kokospalme/HW_LipoMeter5S/Docs/ESP_LayoutPins.fld/image001.jpg

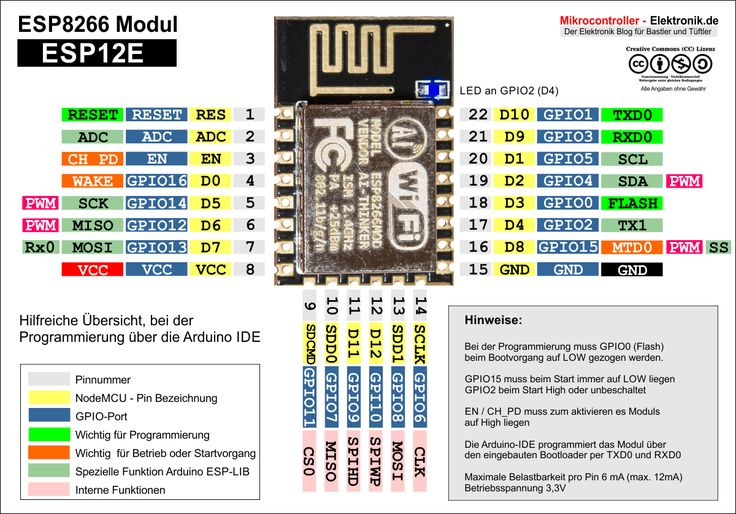
Docs/ESP_LayoutPins.fld/image001.jpg
