kokospalme/HW_LipoMeter5S/Docs/ESP_LayoutPins.fld/image003.png

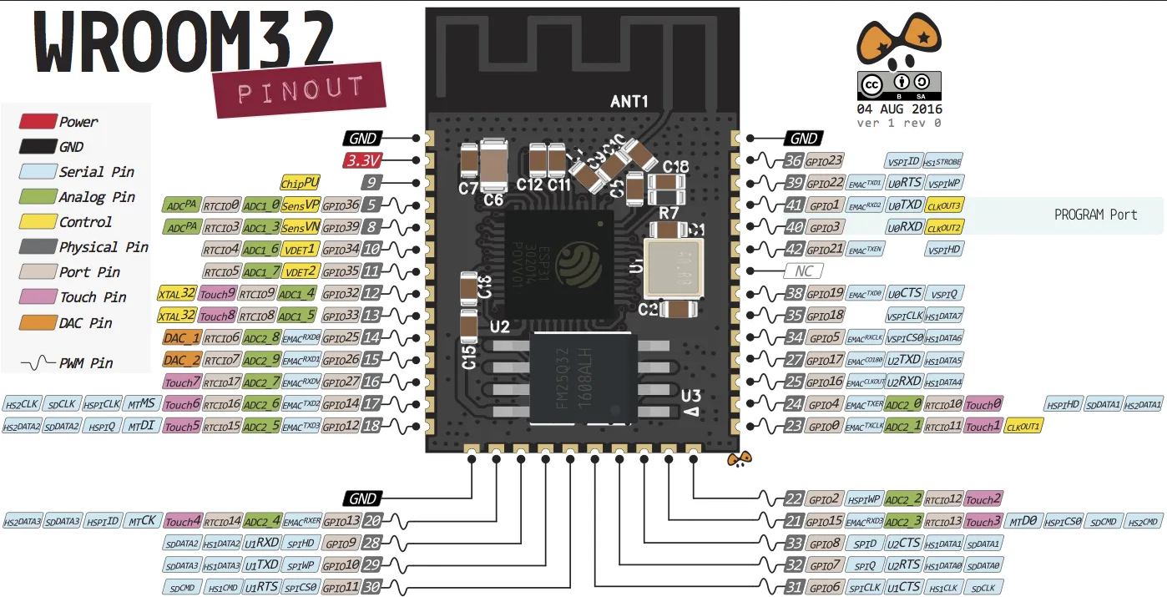
Docs/ESP_LayoutPins.fld/image003.png
