kokospalme/HW_LipoMeter5S/Docs/ESP_LayoutPins.docx

# ESP8266

## Layout


## Pins

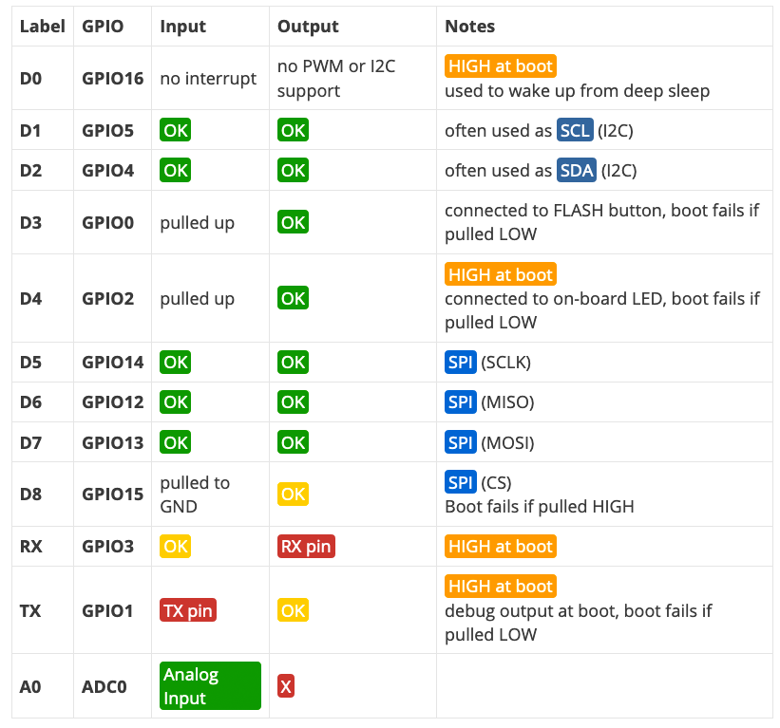
[picture p3: figure]

# ESP32

## Layout (32D)


## Pins

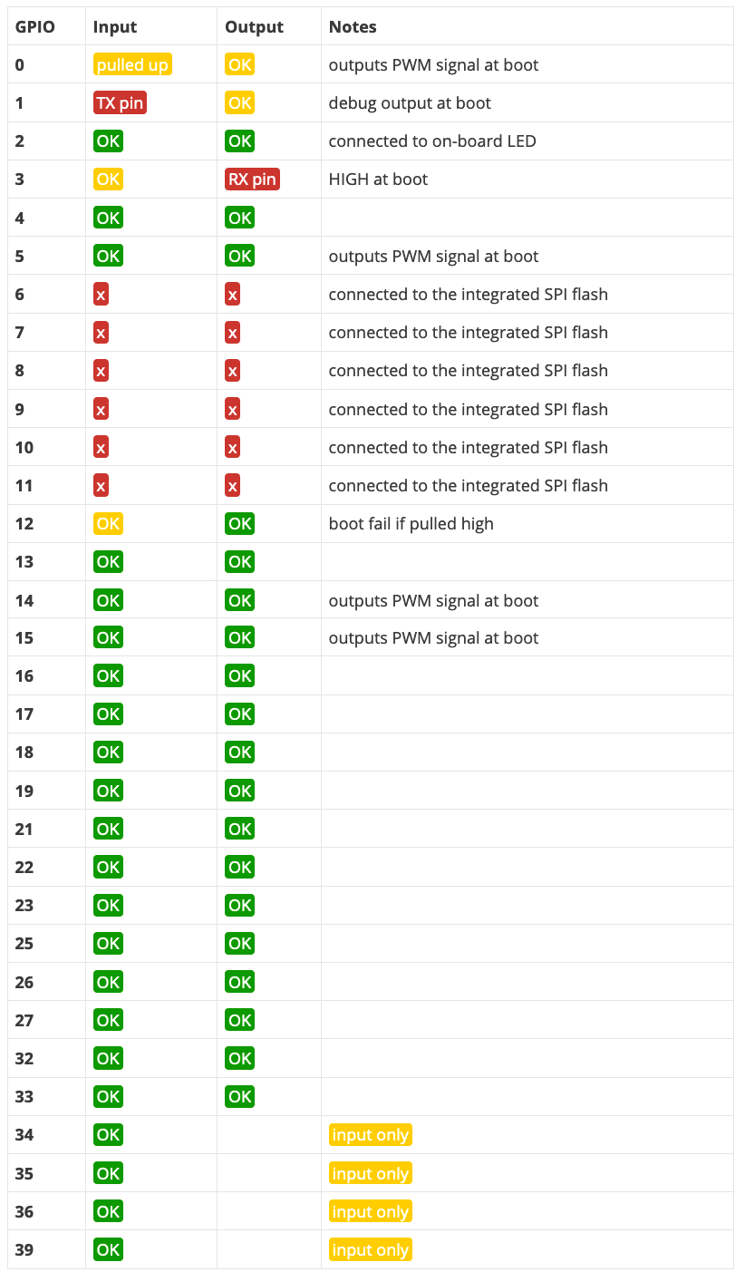
[picture p4: figure]

# ESP-WROOM-02

## Layout

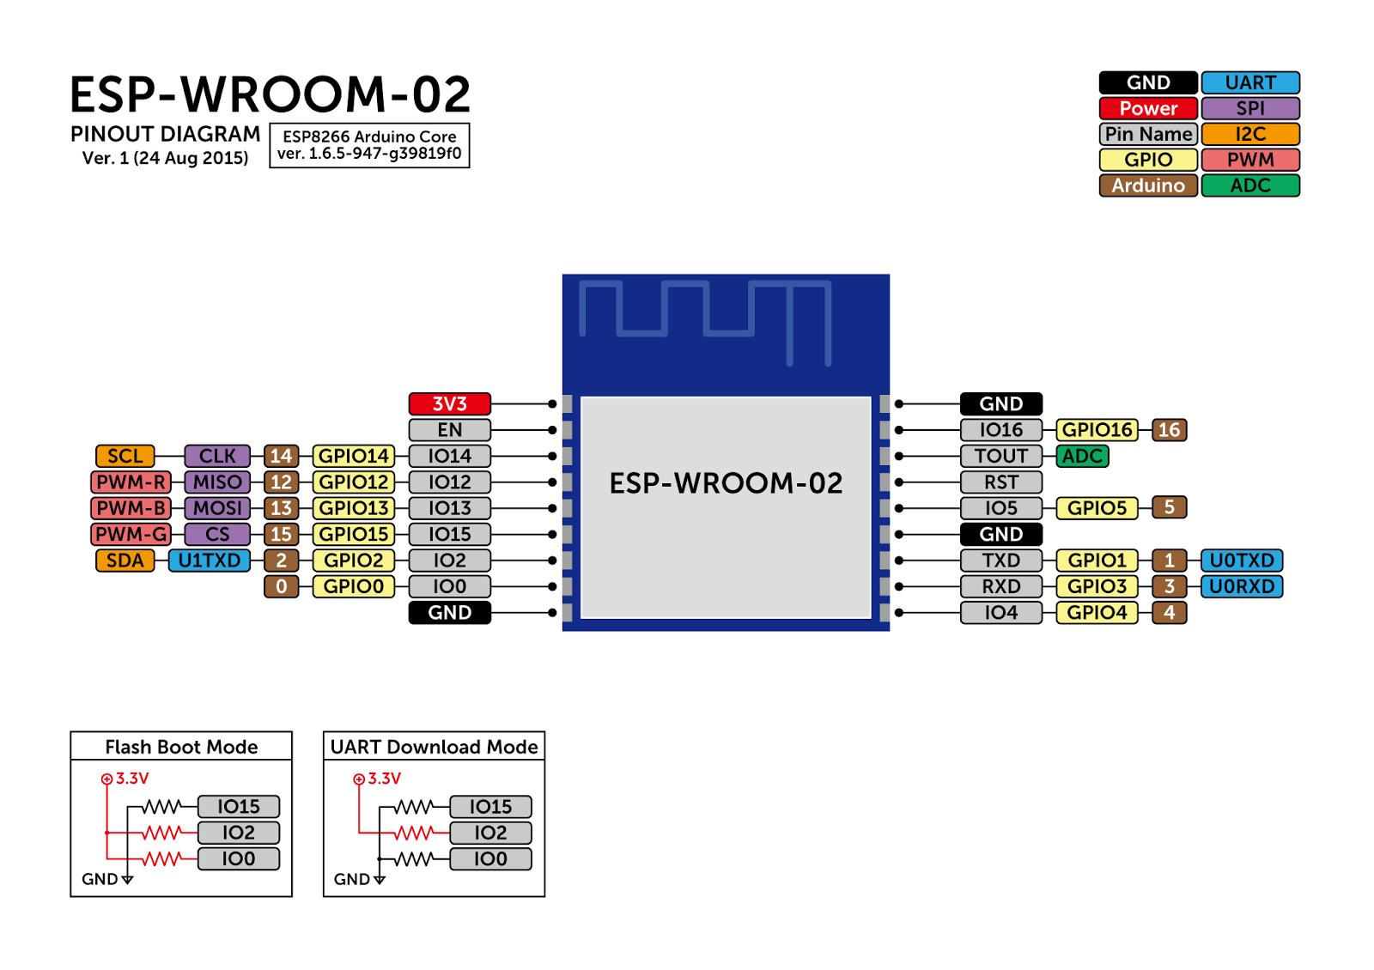
[picture p5: figure]
