kokospalme/HW_LipoMeter5S/Docs/Alice' Hase2.bmp

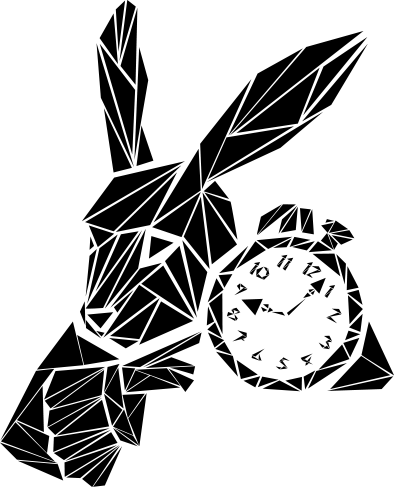
Docs/Alice' Hase2.bmp
