kokospalme/HW_LipoMeter5S/PicoPar6/CAD/par-16-1.snapshot.2/Par-16-Ring-3.png

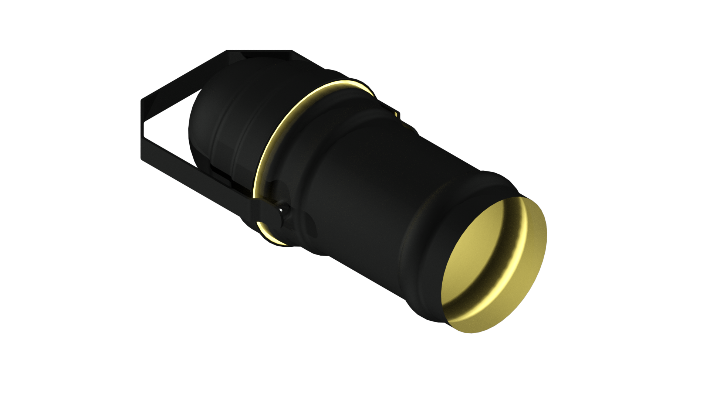
PicoPar6/CAD/par-16-1.snapshot.2/Par-16-Ring-3.png
