kokospalme/HW_LipoMeter5S/PicoPar6/PicoPar6_LED3x/CAD/Zusammenbau_2020-Apr-13_08-45-55PM-000_CustomizedView1124042807_png.png

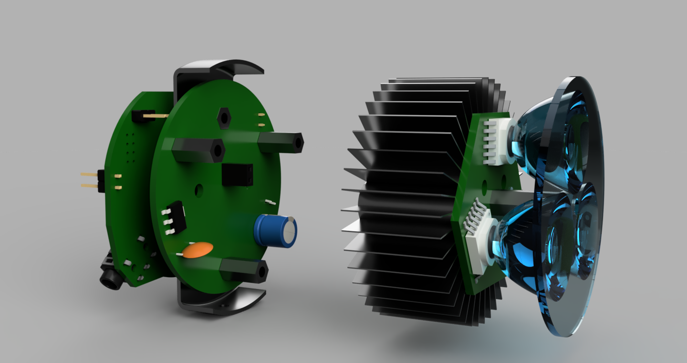
PicoPar6/PicoPar6_LED3x/CAD/Zusammenbau_2020-Apr-13_08-45-55PM-000_CustomizedView1124042807_png.png
