kokospalme/HW_LipoMeter5S/PicoPar6/PicoPar6_LED3x/CAD/Zusammenbau_2020-Apr-13_08-47-48PM-000_CustomizedView13101867357_png.png

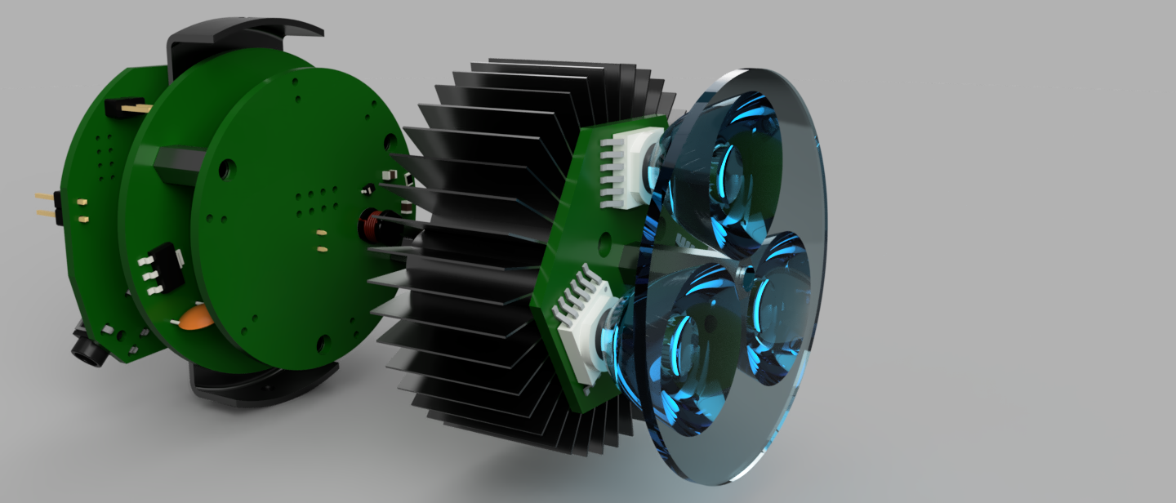
PicoPar6/PicoPar6_LED3x/CAD/Zusammenbau_2020-Apr-13_08-47-48PM-000_CustomizedView13101867357_png.png
