kokospalme/HW_LipoMeter5S/ArtnetNode/ArtnetNodeV0_5BOM.xlsx

Comment | Designator | Footprint | LCSC
100nF | C1,C8,C9,C7,C10,C11,C12 | Capacitor SMD:C 0805 2012 Metric
100uF | C2 | C109392
100nF | C3,C4,C6,C5 | Capacitor SMD 0603 Metric
LED_PWR | D1 | C228
WS2812B | D2,D3 | LED_SMD:LED_WS2812B_PLCC4_5.0x5.0mm_P3.2mm
USB_B_Micro | J1 | C482361
NEOP2D | J10 | C131337
ANALOG | J11 | Connector_PinSocket_2.54mm:PinSocket_2x04_P2.54mm_Vertical
DIO | J12 | Connector_PinSocket_2.54mm:PinSocket_2x06_P2.54mm_Vertical
Jack-DC | J2 | C381116
CON_PROG | J4 | PinSocket_1x03_P2.54mm_Vertical
DMX2 | J5 | C131339
DMX1 | J6 | C131339
DMXIN | J7 | C131339
NEOP1D | J8 | C131337
NEOP1C | J9 | C131337
PWR_SEL | JP1 | -
1k | R1,R5,R2,R16 | Resistor_SMD 0603 Metric
20k | R22,R24,R28,R26,R39,R37 | Resistor_SMD 0603 Metric
120 | R23,R27,R38 | Resistor_SMD 0603 Metric
4.7k | R3,R4 | Resistor_SMD 0603 Metric
100 | R40,R42,R46 | Resistor_SMD 0603 Metric
10 | R41,R43,R44,R45,R47,R48 | Resistor_SMD 0603 Metric
10k | R6,R8,R7,R9,R11,R13,R12,R10,R15,R18,R35,R34,R33,R36,R14,R17,R19,R20,R21,R25,R29,R30,R31,R32 | Resistor_SMD 0603 Metric
SW_Reset | SW1 | KAN0441C-0252C1 (https://lcsc.com/product-detail/Others_GANGYUAN-KAN0441C-0252C1_C231732.html)
SW_PROG | SW2 | KAN0441C-0252C2 (https://lcsc.com/product-detail/Others_GANGYUAN-KAN0441C-0252C1_C231732.html)
SW_NEX | SW3 | KAN0441C-0252C3
SW_NL | SW4 | KAN0441C-0252C4
SW_NR | SW5 | KAN0441C-0252C5
SW_NENT | SW6 | KAN0441C-0252C6
LM1117-5.0 | U1 | C126028
W5500_mini | U12 | custom:W5500_mini
LM1117-3.3 | U2 | SOT-223-3
ESP32-WROOM | U3 | ESP32-WROOM-32U (https://lcsc.com/product-detail/_Espressif-Systems-ESP32-WROOM-32U_C328062.html)
OLED_0.96-I2C | U4 | KiCad-SSD1306_OLED-0:SSD1306_OLED-0.96-128x64_I2C
PCA9555 | U5 | SSOP-24_5.3x8.2mm_P0.65mm
MAX485E | U7,U10,U6 | SOIC-8_3.9x4.9mm_P1.27mm
SN65176D | U8,U9,U11 | SOIC-8_3.9x4.9mm_P1.27mm
