kokospalme/HW_LipoMeter5S/PicoPar6/BOM/LCSC_Exported_20200412_154108.xlsx

LCSC Part Number | Manufacture Part Number | Manufacturer | Package | Customer # | C357398 | Order Qty. | Unit Price | PCB | PCB Qty | PCB2 | PCB Qty2 | units p PCB | price pPCB
C347101 | RS-05MR200FT | FH(Guangdong Fenghua Advanced Tech) | 0805 |  | 0.2 ±1% 1/8W 0805 Chip Resistor - Surface Mount RoHS | 50 | 0.006560 € | - |  |  |  | 0 | 0
C111516 | SPHD-002T-P0.5 | JST Sales America | - |  | Crimping terminal 24~28 0.08~0.21 UL , RoHS , CSA Terminals RoHS | 100 | 0.010421 € | DRV | 12 |  |  | 12 | 0.125052
C113628 | AL8807W5-7 | Diodes Incorporated | SOT-25 |  | DC DC Regulator Step-down 有 6V 36V SOT-25 LED Drivers RoHS | 30 | 0.305455 € | DRV | 6 |  |  | 6 | 1.83273
C131337 | B2B-PH-K-S(LF)(SN) | JST Sales America | Through Hole |  | PH Header Male Pin 0.079"(2.00mm) 2 Through Hole Wire To Board / Wire To Wire Connector RoHS | 40 | 0.028961 € | DRV | 6 |  |  | 6 | 0.173766
C155590 | BAT20JFILM | STMicroelectronics | SOD-323 |  | 23V 1A 620mV @ 1A SOD-323 Schottky Barrier Diodes (SBD) RoHS | 30 | 0.066167 € | DRV | 6 |  |  | 6 | 0.397002
C157955 | PHR-2 | JST Sales America | P=2mm |  | PH 2 0.079"(2.00mm) 1 Male P=2mm Rectangular Connectors Housings RoHS | 50 | 0.011696 € | DRV | 6 | MAINSUP | 1 | 7 | 0.081872
C157975 | B8B-PHDSS(LF)(SN) | JST Sales America | Through Hole,P=2mm |  | PHD Header Male Pin 0.079"(2.00mm) 8 Through Hole,P=2mm Wire To Board / Wire To Wire Connector RoHS | 5 | 0.260909 € | DRV | 1 | MAIN | 1 | 2 | 0.521818
C253597 | ABG06A45M330 | COILANK INTERNATIONAL | SMD,6x6mm |  | 33uH ±20% 1.49A 132mΩ SMD,6x6mm Power Inductors RoHS | 30 | 0.078257 € | DRV | 6 |  |  | 6 | 0.469542
C28323 | CL21B105KBFNNNE | Samsung Electro-Mechanics | 0805 |  | 1uF ±10% 50V X7R 0805 Multilayer Ceramic Capacitors MLCC - SMD/SMT RoHS | 60 | 0.018812 € | DRV | 6 | MAIN | 2 | 8 | 0.150496
C304874 | RS-05MR22JT | FH(Guangdong Fenghua Advanced Tech) | 0805 |  | 0.22 ±5% 1/8W 0805 Chip Resistor - Surface Mount RoHS | 50 | 0.009769 € | DRV | 6 |  |  | 6 | 0.058614
C343626 | 1520-1140CNG0S087001 | HOAUC | Through Hole,P=2mm |  | Pin Header Male Pin 0.079"(2.00mm) 40 1 Through Hole,P=2mm Pin Header & Female Header RoHS | 5 | 0.089702 € | DRV | 0.05 |  |  | 0.05 | 0.0044851
C49217 | 0805F225M500NT | FH(Guangdong Fenghua Advanced Tech) | 0805 |  | 2.2uF ±20% 50V Y5V 0805 Multilayer Ceramic Capacitors MLCC - SMD/SMT RoHS | 40 | 0.029801 € | DRV | 6 |  |  | 6 | 0.178806
C103955 | RTT05121JTP | RALEC | 0805 |  | 120 ±5% 1/8W ±100ppm/°C 0805 Chip Resistor - Surface Mount RoHS | 100 | 0.002262 € | MAIN | 1 |  |  | 1 | 0.002262
C126027 | LM1117S-3.3 | HTC Korea TAEJIN Tech | SOT-223 |  | Fixed 12V 3.3V 1A SOT-223 Low Dropout Regulators(LDO) RoHS | 5 | 0.119779 € | MAIN | 1 |  |  | 1 | 0.119779
C169103 | CRCW060310K0JNEA | Vishay Intertech | 0603 |  | 10K ±5% 1/10W 0603 Chip Resistor - Surface Mount RoHS | 100 | 0.006405 € | MAIN | 11 |  |  | 11 | 0.070455
C18167 | C18167 | BOOMELE(Boom Precision Elec) | Through Hole |  | 3.5mm Plug-in headphone holder 5 Female Horizontal Through Hole Audio & Video Connectors RoHS | 20 | 0.054684 € | MAIN | 2 |  |  | 2 | 0.109368
C269707 | RMC060320K1%N | TyoHM | 0603 |  | 20K ±1% 1/10W 0603 Chip Resistor - Surface Mount RoHS | 100 | 0.002541 € | MAIN | 2 |  |  | 2 | 0.005082
C426569 | BSS138 | Slkor(SLKORMICRO Elec.) | SOT-23 |  | N Channel 50V 220mA 1.6V @ 1mA 3.5Ω @ 220mA,10V 225mW SOT-23 MOSFET RoHS | 50 | 0.011741 € | MAIN | 2 |  |  | 2 | 0.023482
C468242 | SN75176ADR | Texas Instruments | SOIC-8 |  | SOIC-8 Logic-Buffers, Drivers, Receivers, Transceivers RoHS | 5 | 0.308636 € | MAIN | 1 |  |  | 1 | 0.308636
C10752 | 1000uF 10V 8*12 | CX(Dongguan Chengxing Elec) | Radial,8x12mm |  | 1000uF ±20% 10V 8x12 2000Hrs @ 105℃ Radial,8x12mm Aluminum Electrolytic Capacitors - Leaded RoHS | 20 | 0.026452 € | MAINSUP | 1 |  |  | 1 | 0.026452
C173752 | S2B-PH-K-S(LF)(SN) | JST Sales America | Through Hole,P=2mm |  | PH Header Male Pin 0.079"(2.00mm) 2 Through Hole,P=2mm Wire To Board / Wire To Wire Connector RoHS | 20 | 0.038959 € | MAINSUP | 1 |  |  | 1 | 0.038959
C353913 | CC1H104ZC4PD3F5P30MF | Dersonic | Through Hole,P=5.08mm |  | 100nF -20%~+80% 50V Through Hole,P=5.08mm Ceramic Disc Capacitors RoHS | 50 | 0.010166 € | MAINSUP | 1 |  |  | 1 | 0.010166
C49661 | C49661 | BOOMELE(Boom Precision Elec) | P=2.54mm |  | Female Header Female Socket 0.100"(2.54mm) 2 1 P=2.54mm Pin Header & Female Header RoHS | 40 | 0.027342 € | MAINSUP | 2 |  |  | 2 | 0.054684
C305416 |  |  | TO-220 |  | LM7805 |  | 0.166136 € | MAINSUP | 1 |  |  | 1 | 0.166136
C114586 | WS2812B-B | Worldsemi | SMD,5x5mm | 1 | RGB 620~630nmRed,515~530nmGreen,465~475nmBlue SMD,5x5mm Light Emitting Diodes (LED) RoHS | 5 | 0.099749 € | UI | 1 |  |  | 1 | 0.099749
C123700 | HP-5M3*5 | HIWA | M3*5 |  | M3*5 Studs RoHS | 40 | 0.020776 € |  |  |  |  | 0 | 0
C139741 | C139741 | Made in China | M3 |  | M3 Screw RoHS | 50 | 0.004642 € |  |  |  |  | 0 | 0
C158133 | RTT05R240FTP | RALEC | 0805 |  | 0.24 ±1% 1/8W ±200ppm/°C 0805 Chip Resistor - Surface Mount RoHS | 50 | 0.003641 € |  |  |  |  | 0 | 0
C185215 | 22041021 | MOLEX | Through Hole |  | Header Male Pin 0.098"(2.50mm) 2 Through Hole Wire To Board / Wire To Wire Connector RoHS | 30 | 0.051912 € |  |  |  |  | 0 | 0
C24084 | 0805W8F300LT5F | UNI-ROYAL(Uniroyal Elec) | 0805 |  | 0.3 ±1% 1/8W ±800ppm/°C 0805 Chip Resistor - Surface Mount RoHS | 50 | 0.004544 € |  |  |  |  | 0 | 0
C277657 | 511910200 | MOLEX | - |  | Connectors - Housings RoHS | 30 | 0.046259 € |  |  |  |  | 0 | 0
C293610 | 508029001 | MOLEX | - |  | Terminals RoHS | 100 | 0.019325 € |  |  |  |  | 0 | 0
C357397 | PM3X4 | Shuntian | 3X4mm |  | 3X4mm Screw RoHS | 100 | 0.002488 € |  |  |  |  | 0 | 0
C357398 | PM3X5 | Shuntian | 3X5mm |  | 3X5mm Screw RoHS | 100 | 0.002597 € |  |  |  |  | 0 | 0
C357546 | PM3X12 | Shuntian | 3X12mm |  | 3X12mm Screw RoHS | 50 | 0.004410 € |  |  |  |  | 0 | 0
C55707 | C55707 | Made in China | 3*10mm |  | 3*10mm Studs RoHS | 20 | 0.023978 € |  |  |  |  | 0 | 0
C87703 | C87703 | Made in China | M3*5+6 |  | M3*5+6 Studs RoHS | 20 | 0.022721 € |  |  |  |  | 0 | 0
 |  |  |  |  |  |  |  |  |  |  |  | Bauteile | 5.0293931
