kokospalme/HW_LipoMeter5S/PicoPar6/BOM/picoPar6_stairvile_screwBOM_V1.0.xlsx

Anzahl pcb | Anzahl gesamt | Name | material | LCSC
2 | 10 | screw M3x15 | stahl
3 | 15 | screw M3x5 | stahl | C357398
1 | 5 | nut M3 | stahl | C133377
2 | 10 | stud M3x5 | nylon | C123700
2 | 10 | stud M3x5 | stahl | C123700
3 | 15 | stud M3x10 | stahl | C55707
