kokospalme/HW_LipoMeter5S/PicoPar6/PicoPar6_Driver/EasyEDA_PicoPar6_DriverPCB_V1_0/Pico6 Par_Driver PCB_V1_0_BOM.csv

ID | Name | Designator | Footprint | Quantity | Manufacturer Part | Manufacturer | Supplier | Supplier Part | LCSC Assembly
1 | AL8805 | U2,U6,U1,U3,U5,U4 | SOT23-5 | 6 | AL8805W5-7 | Diodes Incorporated | LCSC | C127927
2 | 1uF | C3,C1,C5,C11,C9,C7 | 0805' | 6 | CL21B105KBFNNNE | SAMSUNG | LCSC | C28323
3 | 2.2uF | C4,C2,C6,C12,C10,C8 | 0805' | 6 | 0805F225M500NT | FH | LCSC | C49217
4 | 0.3R | R1,R3,R6,R5,R2,R4 | 0805' | 6 | 0805W8F300LT5F | UniOhm | LCSC | C24084
5 | 33uH | L1,L2,L3,L5,L6,L4 | SRN6045 | 6 | SWRB1207S-330MT | Sunlord | LCSC | C169375
6 | BAT20JFILM | D1,D3,D2,D5,D6,D4 | SOD-323_L1.8-W1.3-LS2.5-RD | 6 | BAT20JFILM | STMicroelectronics | LCSC | C155590 | Yes
7 | P_CTRL | P1 | HDR-TH_8P-P2.54-V-R2-C4-S2.54 | 1 | Header2X4P 2.54mm | ReliaPro | LCSC | C58363
8 | CH_W | P6 | CONN-TH_22041021 | 1 | 22041021 | MOLEX | LCSC | C185215
9 | CH_UV | P7 | CONN-TH_22041021 | 1 | 22041021 | MOLEX | LCSC | C185215
10 | P_PWR | P2 | CONN-TH_22041021 | 1 | 22041021 | MOLEX | LCSC | C185215
11 | CH_B | P5 | CONN-TH_22041021 | 1 | 22041021 | MOLEX | LCSC | C185215
12 | CH_G | P4 | CONN-TH_22041021 | 1 | 22041021 | MOLEX | LCSC | C185215
13 | CH_R | P3 | CONN-TH_22041021 | 1 | 22041021 | MOLEX | LCSC | C185215
14 | CH_A | P8 | CONN-TH_22041021 | 1 | 22041021 | MOLEX | LCSC | C185215
