kokospalme/HW_LipoMeter5S/PicoPar6/CAD/MainSupply/PicoPar6_MainSupply_V1_0.step

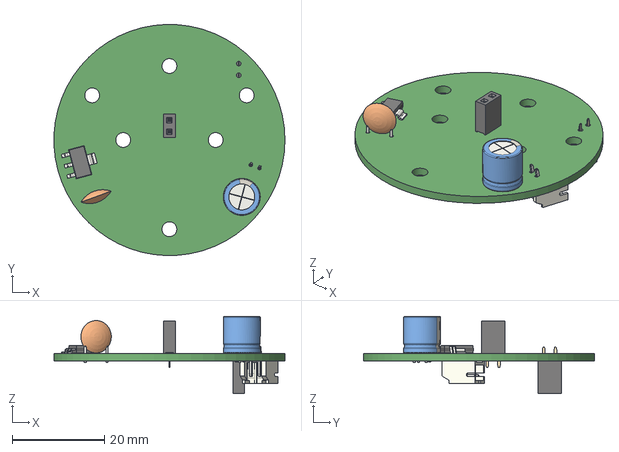
[picture p10: CAD file, 2020-04-25]
PicoPar6/CAD/MainSupply/PicoPar6_MainSupply_V1_0.step
50.0 x 50.0 x 16.7 mm
