kokospalme/HW_LipoMeter5S/PicoPar6/PicoPar6_Mainboard/V2/Gerber/PicoPar6_Mainboard-Edge_Cuts.dxf

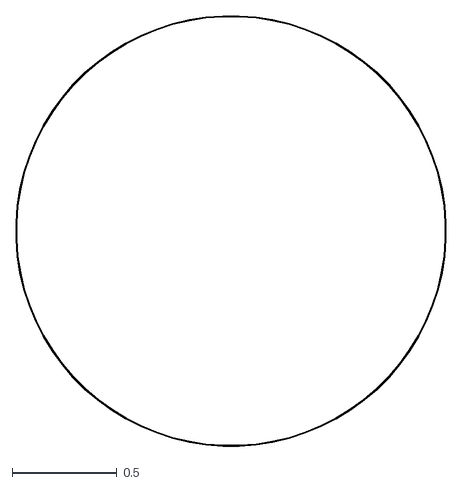
[picture p11: CAD file, 2020-04-25]
PicoPar6/PicoPar6_Mainboard/V2/Gerber/PicoPar6_Mainboard-Edge_Cuts.dxf
2.05 x 2.05
