kokospalme/HW_LipoMeter5S/Firepot/CAD/Assembly.FCStd

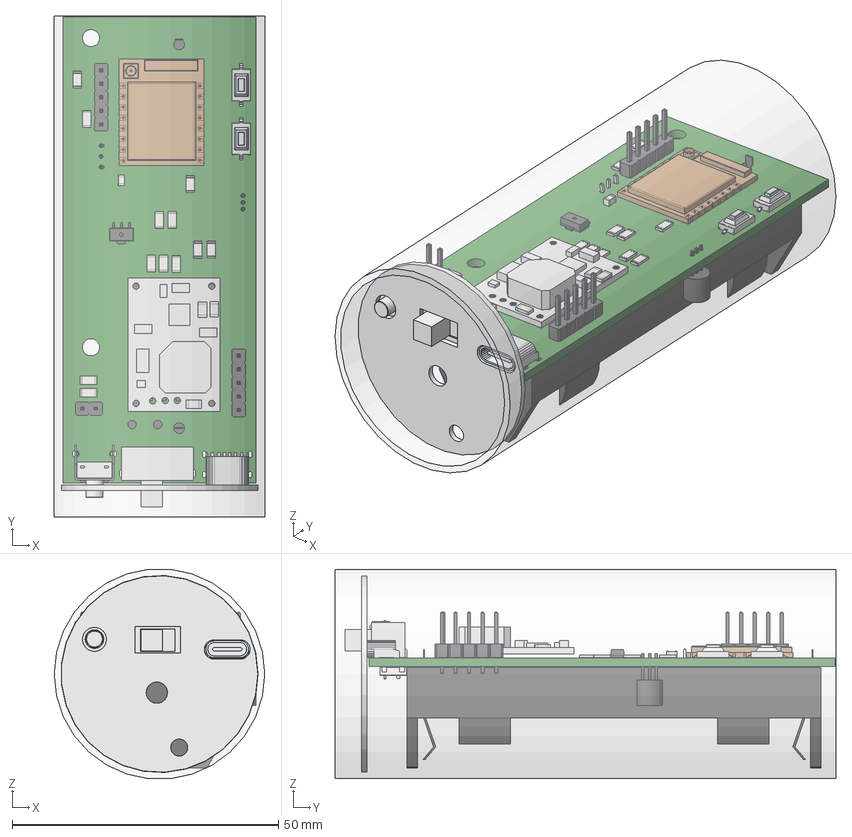
[picture p12: CAD file, 2020-04-25]
Firepot/CAD/Assembly.FCStd
39.5 x 94.0 x 39.3 mm
Rohr
Blende
