kokospalme/HW_LipoMeter5S/PicoPar6/PicoPar6_Mainboard/V2/Gerber/PicoPar6_Mainboard-B_Cu.dxf

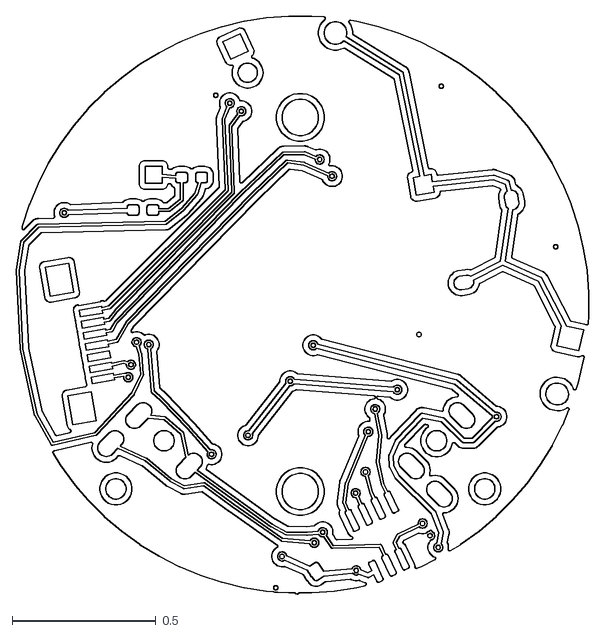
[picture p13: CAD file, 2020-04-25]
PicoPar6/PicoPar6_Mainboard/V2/Gerber/PicoPar6_Mainboard-B_Cu.dxf
1.99 x 2.01
