kokospalme/HW_LipoMeter5S/PicoPar6/PicoPar6_Mainboard/V2/Gerber/PicoPar6_Mainboard-F_Cu.dxf

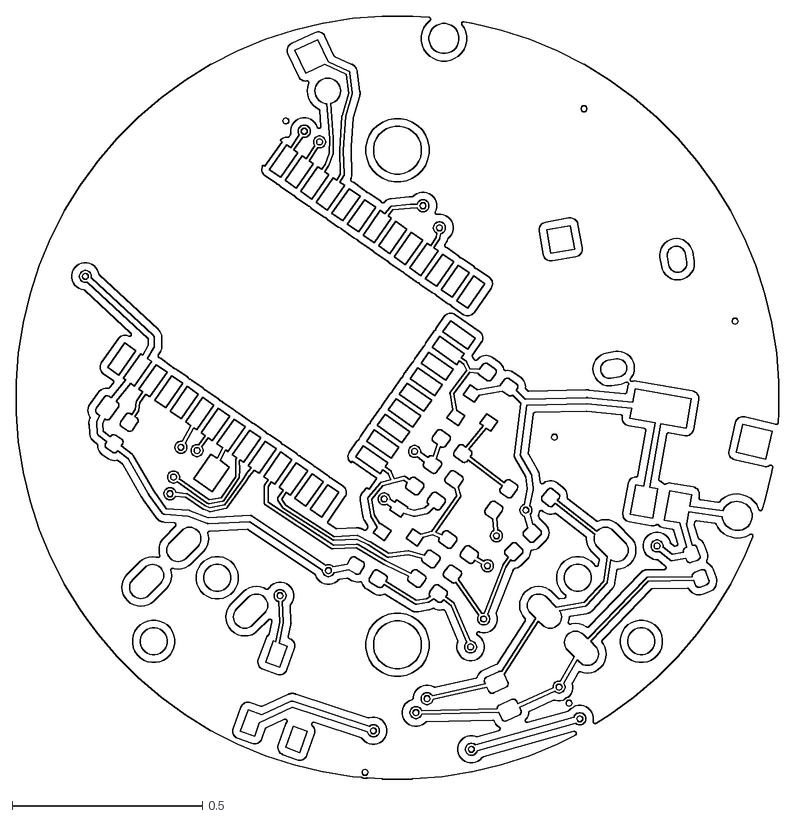
[picture p14: CAD file, 2020-04-25]
PicoPar6/PicoPar6_Mainboard/V2/Gerber/PicoPar6_Mainboard-F_Cu.dxf
2.00 x 2.00
