kokospalme/HW_LipoMeter5S/FaderController/FaceplateV0_1.step

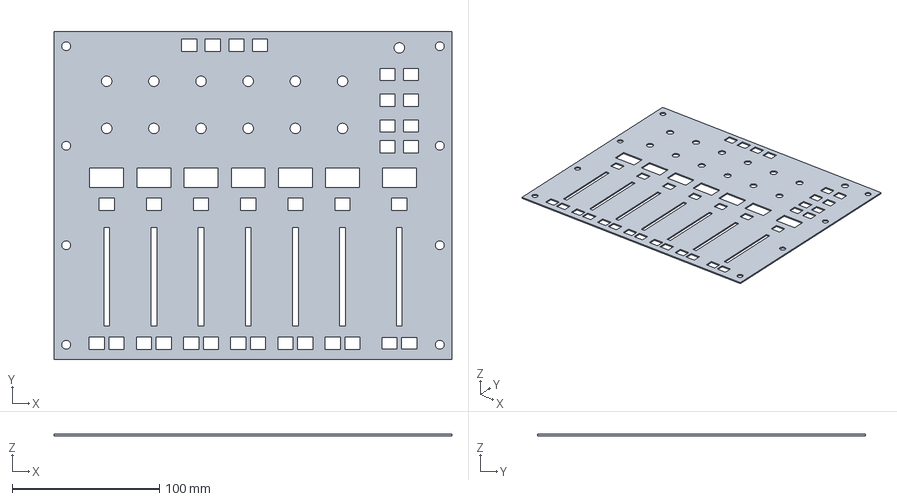
[picture p15: CAD file, 2020-04-25]
FaderController/FaceplateV0_1.step
270.0 x 222.5 x 1.20 mm
