kokospalme/HW_LipoMeter5S/Firepot/CAD/PCB1.FCStd

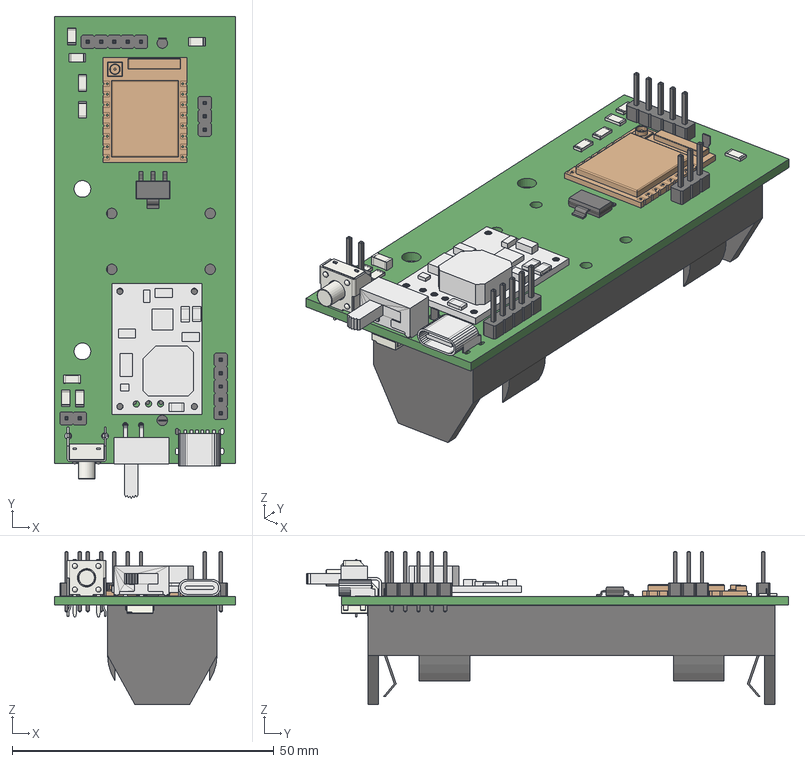
[picture p16: CAD file, 2020-04-25]
Firepot/CAD/PCB1.FCStd
34.5 x 92.0 x 29.2 mm
