kokospalme/HW_LipoMeter5S/PicoPar6/CAD/StairvillePar16/Cap.step

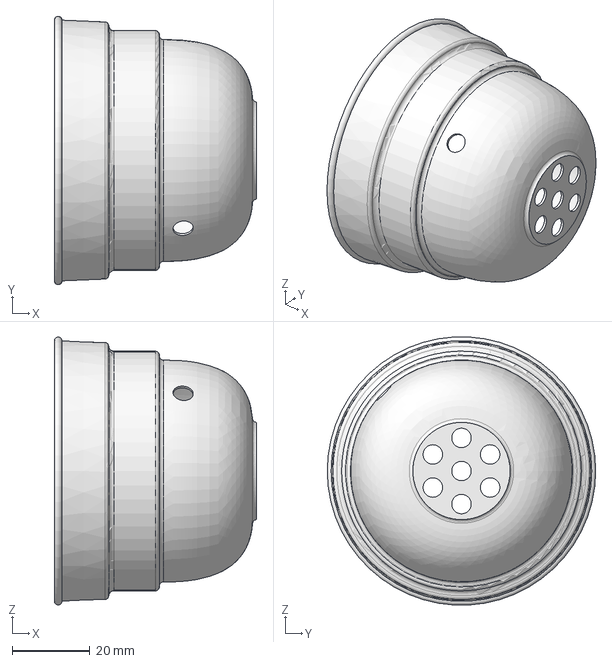
[picture p17: CAD file, 2020-04-25]
PicoPar6/CAD/StairvillePar16/Cap.step
52.0 x 69.0 x 68.9 mm
