kokospalme/HW_LipoMeter5S/PicoPar6/PicoPar6_Driver/PicoPar6_Driver.step

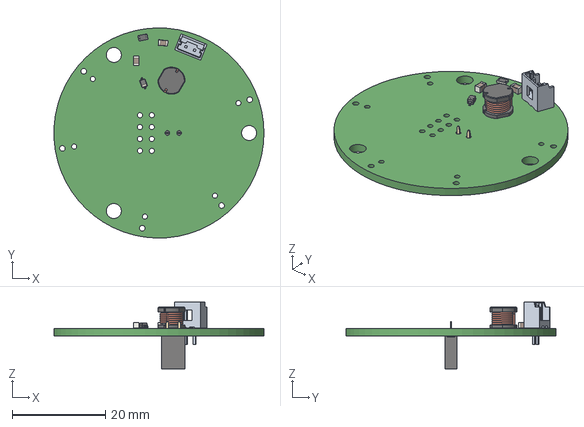
[picture p18: CAD file, 2020-04-25]
PicoPar6/PicoPar6_Driver/PicoPar6_Driver.step
45.0 x 45.0 x 14.2 mm
