kokospalme/HW_LipoMeter5S/PicoPar6/PicoPar6_LED3x/CAD/PicoPar6_LED3x.stp

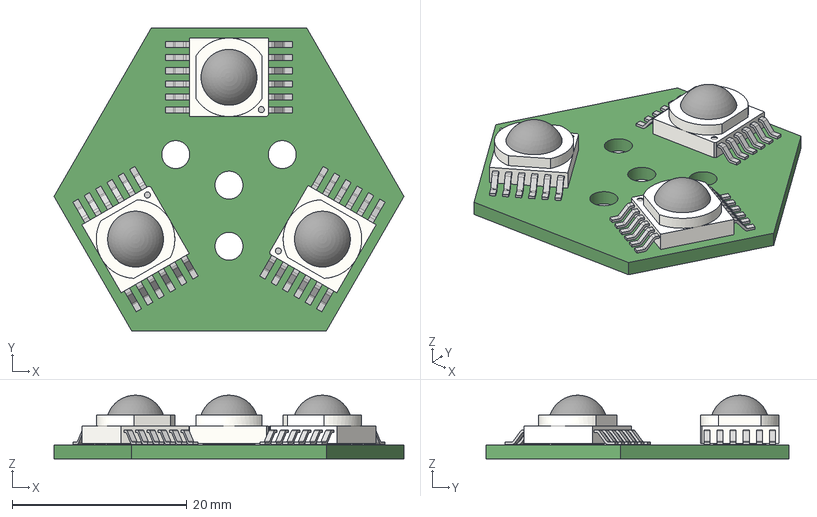
[picture p19: CAD file, 2020-04-25]
PicoPar6/PicoPar6_LED3x/CAD/PicoPar6_LED3x.stp
40.1 x 34.7 x 7.30 mm
