kokospalme/HW_LipoMeter5S/ProgrammerController/Models/DisplayGlass/DisplayGlassV1_0.step

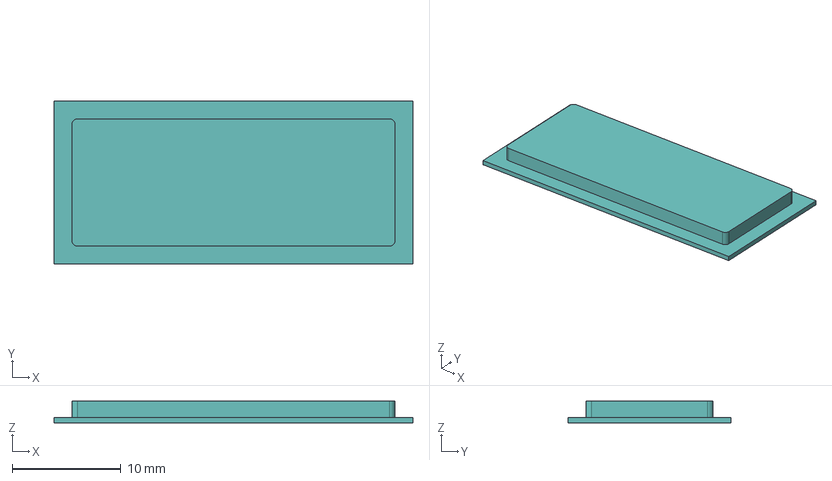
[picture p20: CAD file, 2020-04-25]
ProgrammerController/Models/DisplayGlass/DisplayGlassV1_0.step
33.0 x 15.0 x 2.00 mm
