kokospalme/HW_LipoMeter5S/ProgrammerController/Models/Faceplate/FaceplateMitEncoder.FCStd

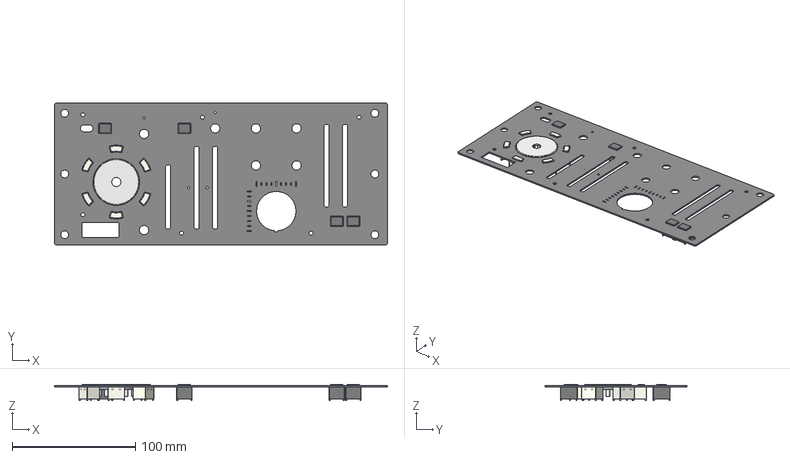
[picture p21: CAD file, 2020-04-25]
ProgrammerController/Models/Faceplate/FaceplateMitEncoder.FCStd
270.0 x 115.0 x 13.3 mm
Baugruppe002
Baugruppe003
Baugruppe004
Baugruppe005
Baugruppe006
Baugruppe007
Baugruppe
Baugruppe008
Baugruppe009
Baugruppe010
