kokospalme/HW_LipoMeter5S/ProgrammerController/Models/Gehaeuse/Seitenteil.FCStd

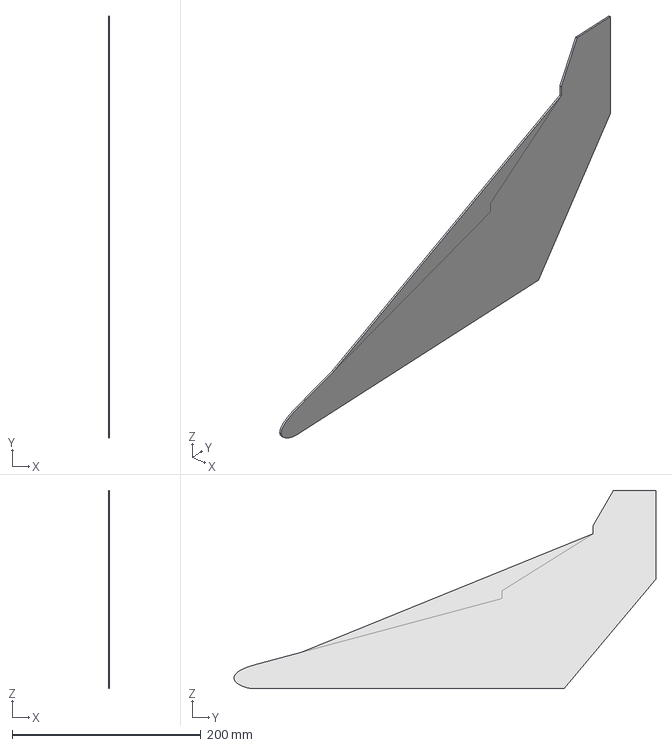
[picture p22: CAD file, 2020-04-25]
ProgrammerController/Models/Gehaeuse/Seitenteil.FCStd
1.50 x 446.7 x 210.1 mm
