kokospalme/HW_LipoMeter5S/ProgrammerController/Models/JoystickCap/JoystickCapV1_1.step

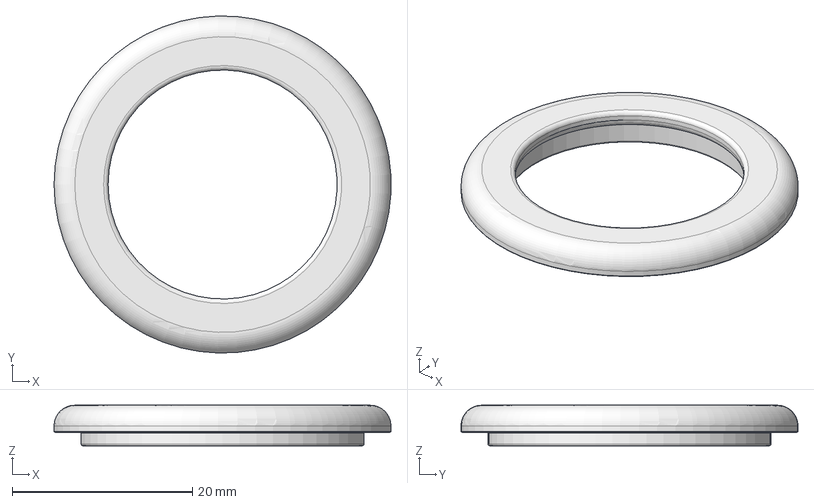
[picture p23: CAD file, 2020-04-25]
ProgrammerController/Models/JoystickCap/JoystickCapV1_1.step
37.4 x 37.4 x 4.50 mm
