kokospalme/HW_LipoMeter5S/ProgrammerController/Models/PotiKnob.step

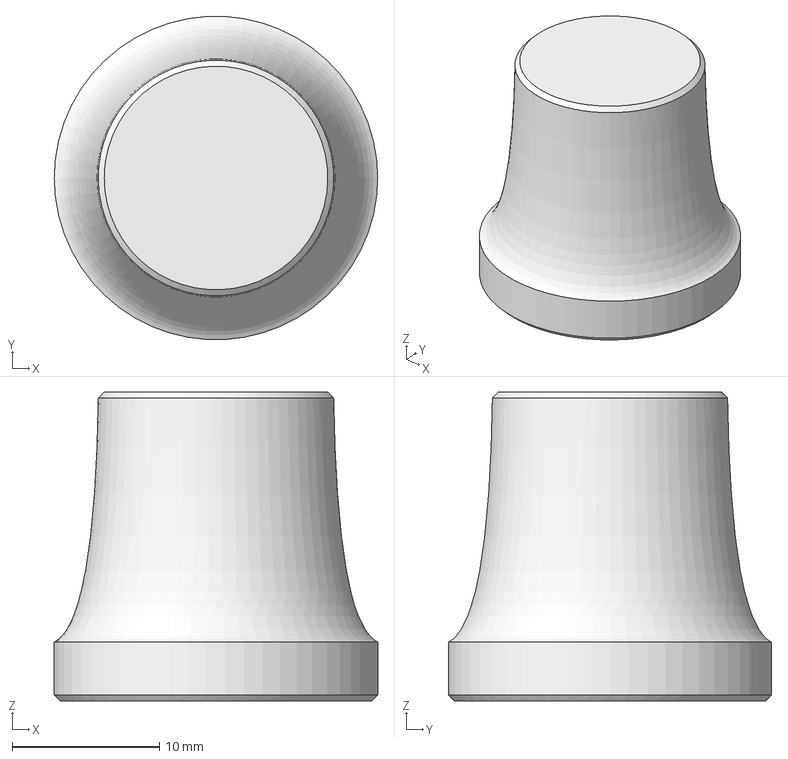
[picture p24: CAD file, 2020-04-25]
ProgrammerController/Models/PotiKnob.step
22.0 x 22.0 x 21.0 mm
