kokospalme/HW_LipoMeter5S/projects/2023/LiPoMeter_5S/LiPoMeter_5S_v1.step

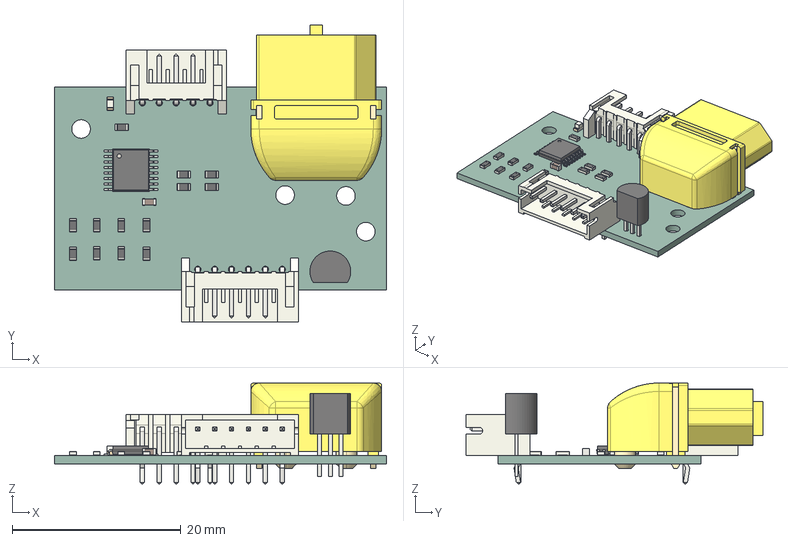
[picture p25: CAD file, 2024-01-23]
projects/2023/LiPoMeter_5S/LiPoMeter_5S_v1.step
39.3 x 35.2 x 12.0 mm
LiPoMeter_5S PCB
