kokospalme/HW_LipoMeter5S/W5500Module/W5500Module.step

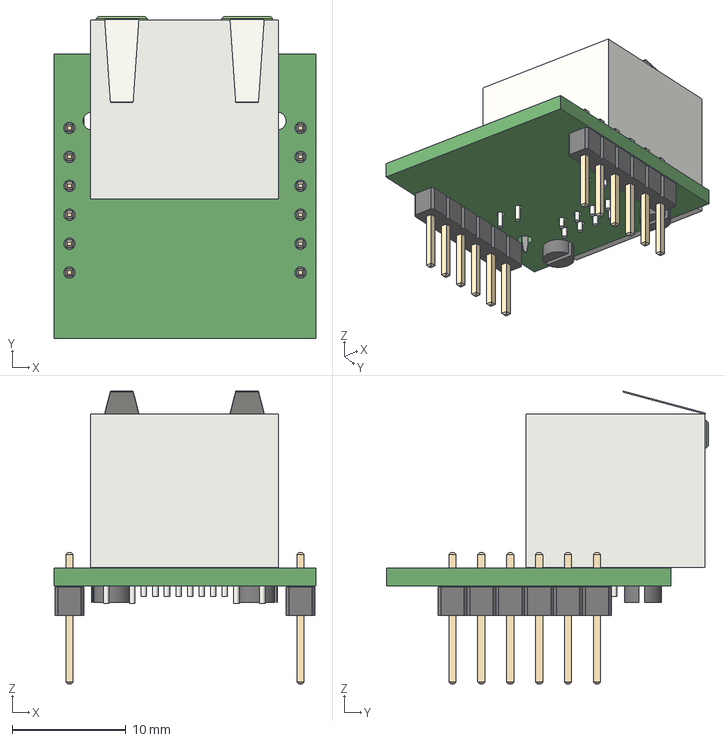
[picture p26: CAD file, 2020-04-25]
W5500Module/W5500Module.step
23.0 x 28.3 x 25.7 mm
