kokospalme/HW_LipoMeter5S/PicoPar6/CAD/par-16-1.snapshot.2/GehäuseVorn v1.step

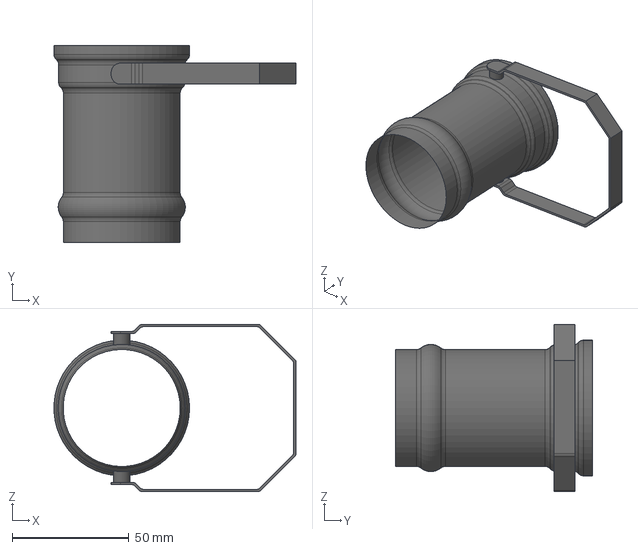
[picture p27: CAD file, 2020-04-25]
PicoPar6/CAD/par-16-1.snapshot.2/GehäuseVorn v1.step
103.4 x 84.0 x 71.5 mm
Aufhängung
Par
