kokospalme/HW_LipoMeter5S/ProgrammerController/Models/Design1.FCStd

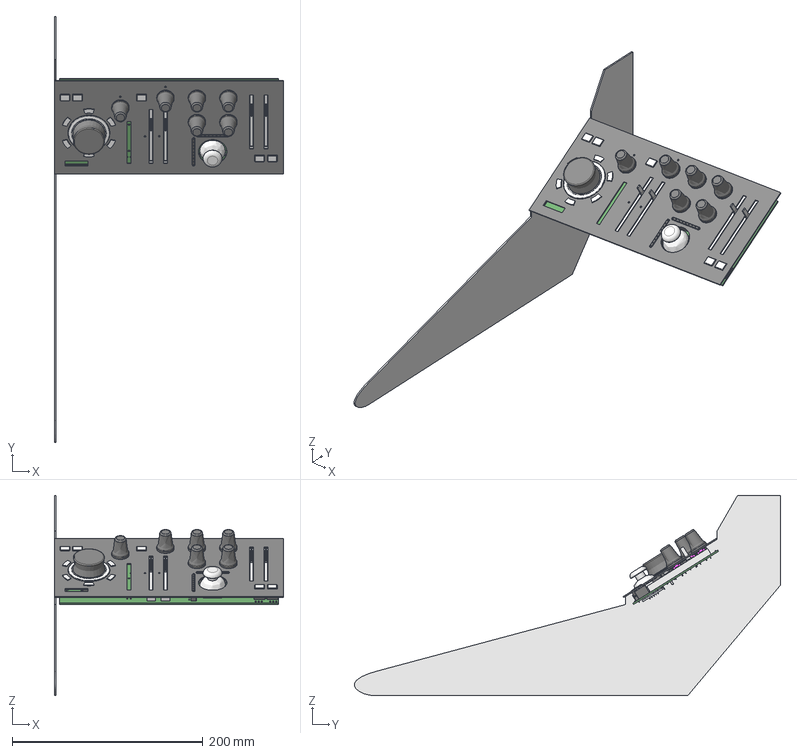
[picture p28: CAD file, 2020-04-25]
ProgrammerController/Models/Design1.FCStd
240.0 x 446.7 x 210.0 mm
SeitenteilAussen
