kokospalme/HW_LipoMeter5S/ProgrammerController/Models/DisplayGlass/DisplayGlass.FCStd

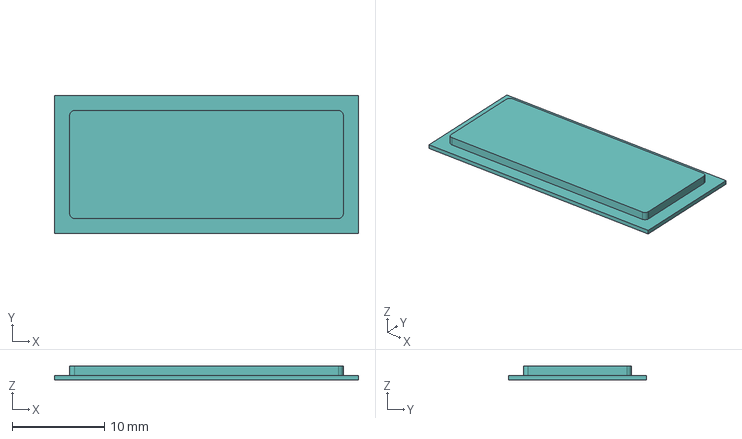
[picture p29: CAD file, 2020-04-25]
ProgrammerController/Models/DisplayGlass/DisplayGlass.FCStd
33.0 x 15.0 x 1.50 mm
