kokospalme/HW_LipoMeter5S/ProgrammerController/Models/Faceplate/2020LUM1PROGRACEV0_9.step

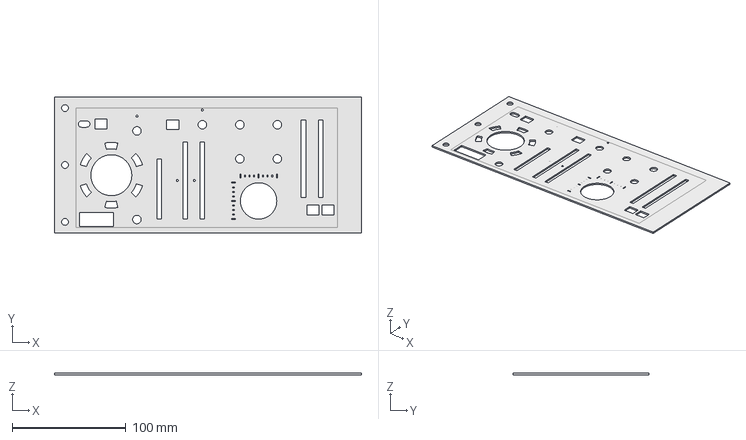
[picture p30: CAD file, 2020-04-25]
ProgrammerController/Models/Faceplate/2020LUM1PROGRACEV0_9.step
270.0 x 120.0 x 1.50 mm
