kokospalme/HW_LipoMeter5S/ProgrammerController/Models/Faceplate/Faceplate.FCStd

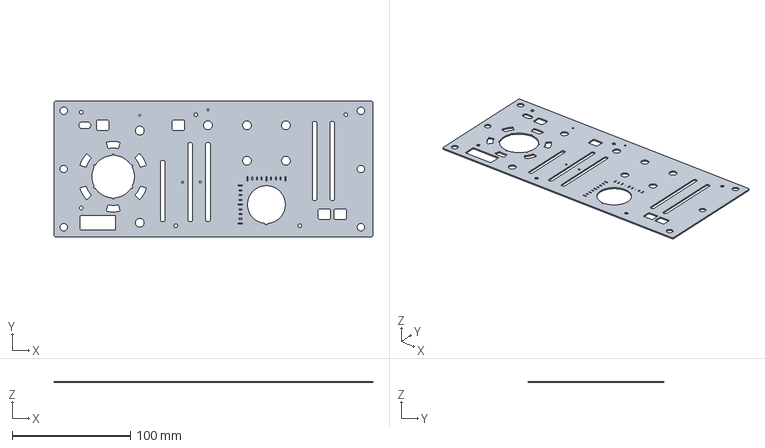
[picture p31: CAD file, 2020-04-25]
ProgrammerController/Models/Faceplate/Faceplate.FCStd
270.0 x 115.0 x 1.20 mm
