kokospalme/HW_LipoMeter5S/ProgrammerController/Models/Joystick_LED.FCStd

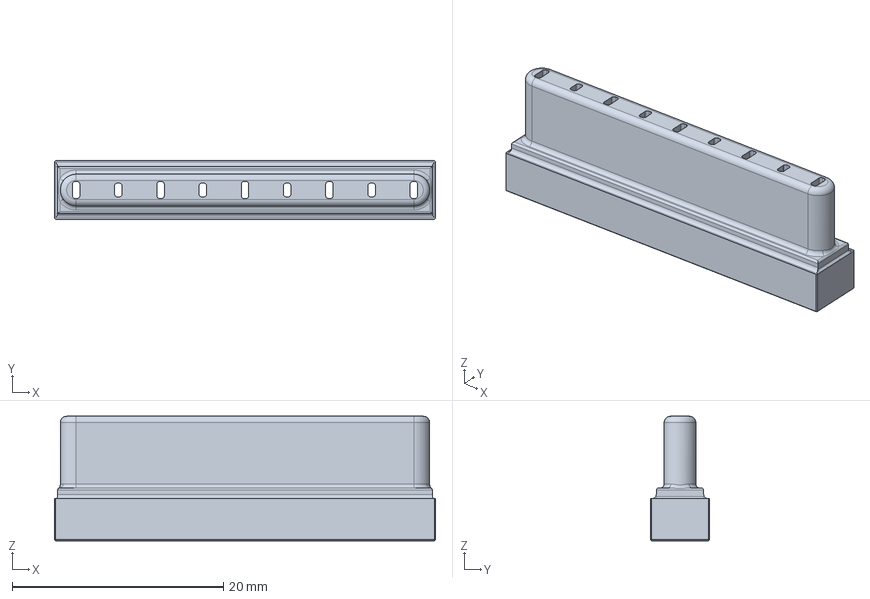
[picture p32: CAD file, 2020-04-25]
ProgrammerController/Models/Joystick_LED.FCStd
36.1 x 5.60 x 11.8 mm
