kokospalme/HW_LipoMeter5S/ProgrammerController/Models/JoystickCap/JoystickWithCapV1_0.step

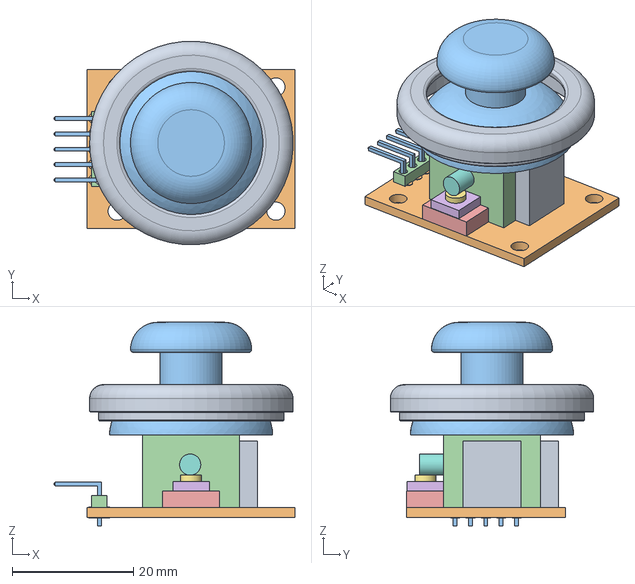
[picture p34: CAD file, 2020-04-25]
ProgrammerController/Models/JoystickCap/JoystickWithCapV1_0.step
39.8 x 33.6 x 33.6 mm
