kokospalme/HW_LipoMeter5S/(list of files, cad)

Other CAD files:
PicoPar6/CAD/par-16-1.snapshot.2/Par-16-Block.dwg
FaderController/Faceplate.FCStd
ProgrammerController/Models/Gehaeuse/SeitenteilAußen.step
ProgrammerController/Models/Gehaeuse/SeitenteilAussen.FCStd
ProgrammerController/Models/Faceplate/FaceplateV1_5.step
ProgrammerController/Models/Gehaeuse/SeitenteilInnen.FCStd
ProgrammerController/Models/Faceplate/Faceplate_V1_4_Final.step
ProgrammerController/Models/JoystickCap/JoystickCap.FCStd
ProgrammerController/Models/PotiKnob1.step
ProgrammerController/Models/JoystickLED_V0_6.step
ProgrammerController/Models/Faceplate/2020LUM1PROGRACEV1_0.FCStd
PicoPar6/PicoPar6_LED3x/CAD/LED_Lens v4.f3d
PicoPar6/PicoPar6_Mainboard/V1/DXF/V1.1/PicoPar6_Mainboard-B_Cu.dxf
PicoPar6/PicoPar6_Mainboard/V1/DXF/V1.1/PicoPar6_Mainboard-B_Mask.dxf
PicoPar6/PicoPar6_Mainboard/V1/DXF/V1.1/PicoPar6_Mainboard-B_Paste.dxf
PicoPar6/PicoPar6_Mainboard/V1/DXF/V1.1/PicoPar6_Mainboard-B_SilkS.dxf
PicoPar6/PicoPar6_Mainboard/V1/DXF/V1.1/PicoPar6_Mainboard-Edge_Cuts.dxf
PicoPar6/PicoPar6_Mainboard/V1/DXF/V1.1/PicoPar6_Mainboard-F_Cu.dxf
PicoPar6/PicoPar6_Mainboard/V1/DXF/V1.1/PicoPar6_Mainboard-F_Mask.dxf
PicoPar6/PicoPar6_Mainboard/V1/DXF/V1.1/PicoPar6_Mainboard-F_Paste.dxf
PicoPar6/PicoPar6_Mainboard/V1/DXF/V1.1/PicoPar6_Mainboard-F_SilkS.dxf
PicoPar6/PicoPar6_Mainboard/V2/Gerber/PicoPar6_Mainboard-B_Mask.dxf
PicoPar6/PicoPar6_Mainboard/V2/Gerber/PicoPar6_Mainboard-B_Paste.dxf
PicoPar6/PicoPar6_Mainboard/V2/Gerber/PicoPar6_Mainboard-B_SilkS.dxf
PicoPar6/PicoPar6_Mainboard/V2/Gerber/PicoPar6_Mainboard-F_Mask.dxf
PicoPar6/PicoPar6_Mainboard/V2/Gerber/PicoPar6_Mainboard-F_Paste.dxf
PicoPar6/PicoPar6_Mainboard/V2/Gerber/PicoPar6_Mainboard-F_SilkS.dxf
ProgrammerController/Models/Faceplate/Faceplate_V1_4_FINAL.dxf
ProgrammerController/Models/Faceplate/faceplateV0_4.step
ProgrammerController/Models/JoystickCap/JoystickCapV1_0.step
ProgrammerController/Models/JoystickLED_V0_5.step
ProgrammerController/Models/PotiKnob.FCStd
