kokospalme/HW_LipoMeter5S/ArtnetNode/ArtnetNode.pdf

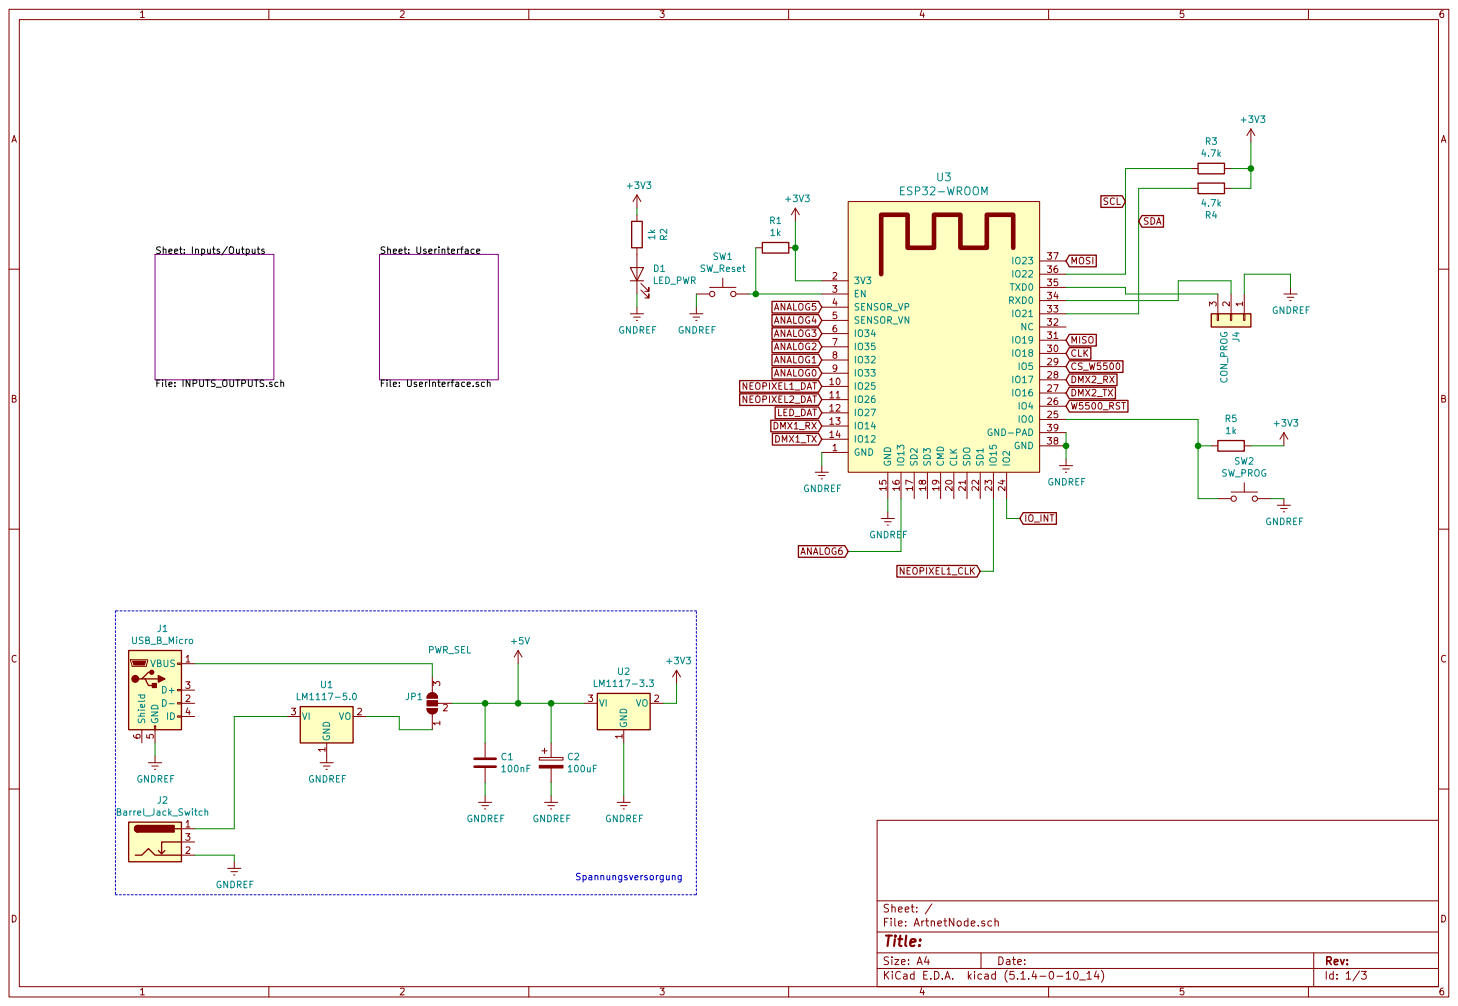
[picture p35: page 1]

Id: 1/3 Title: File: ArtnetNode.sch Sheet: /

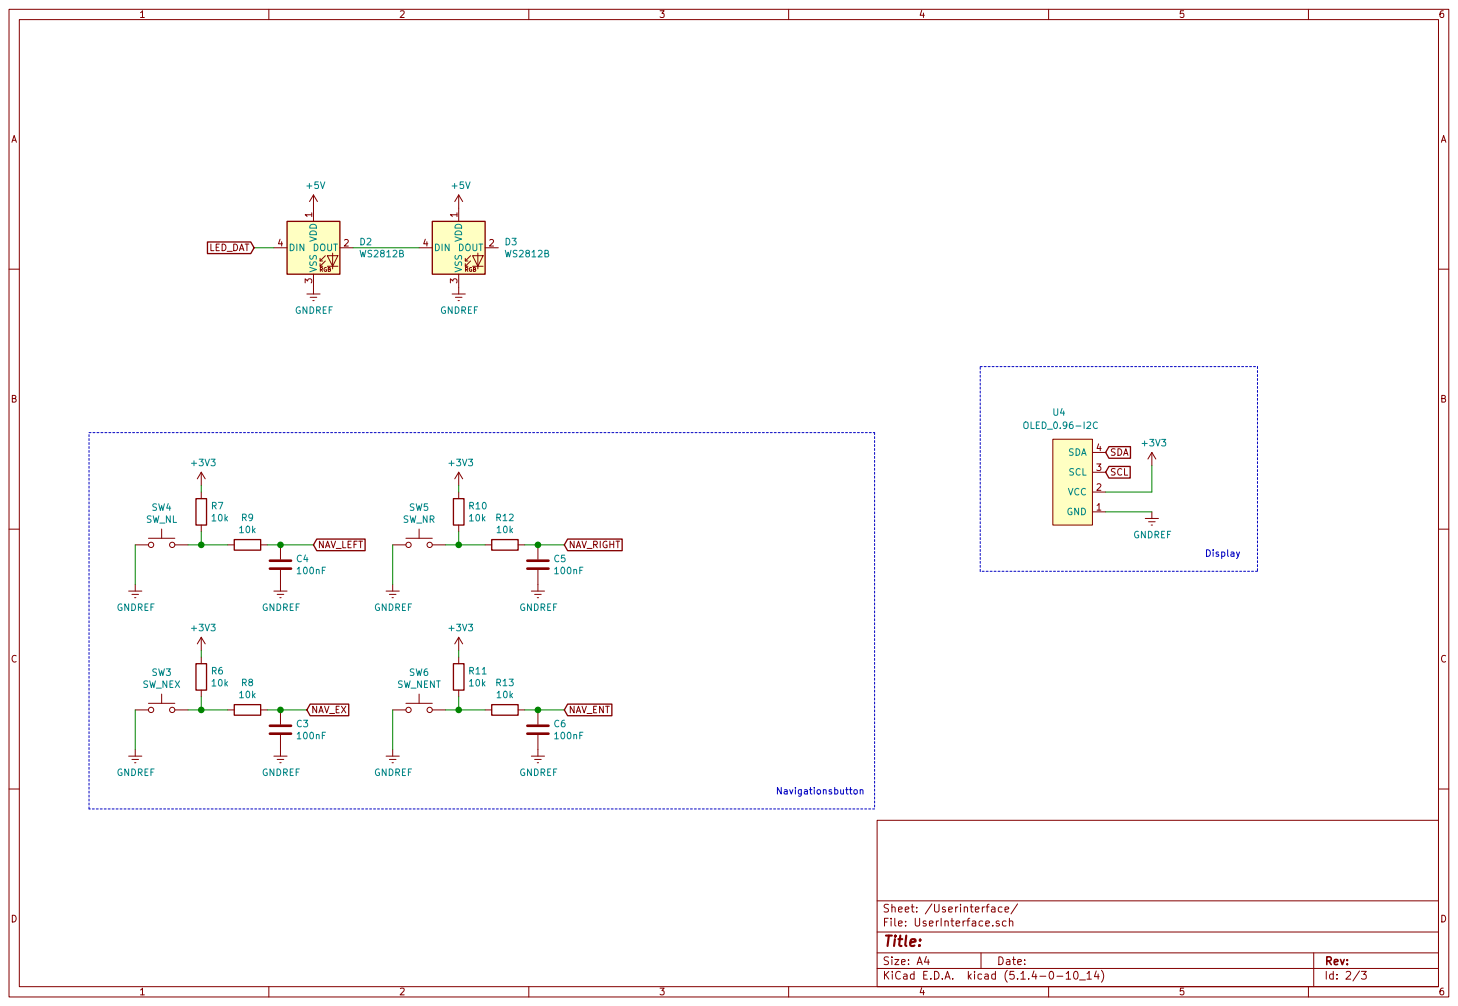
[picture p36: page 2]

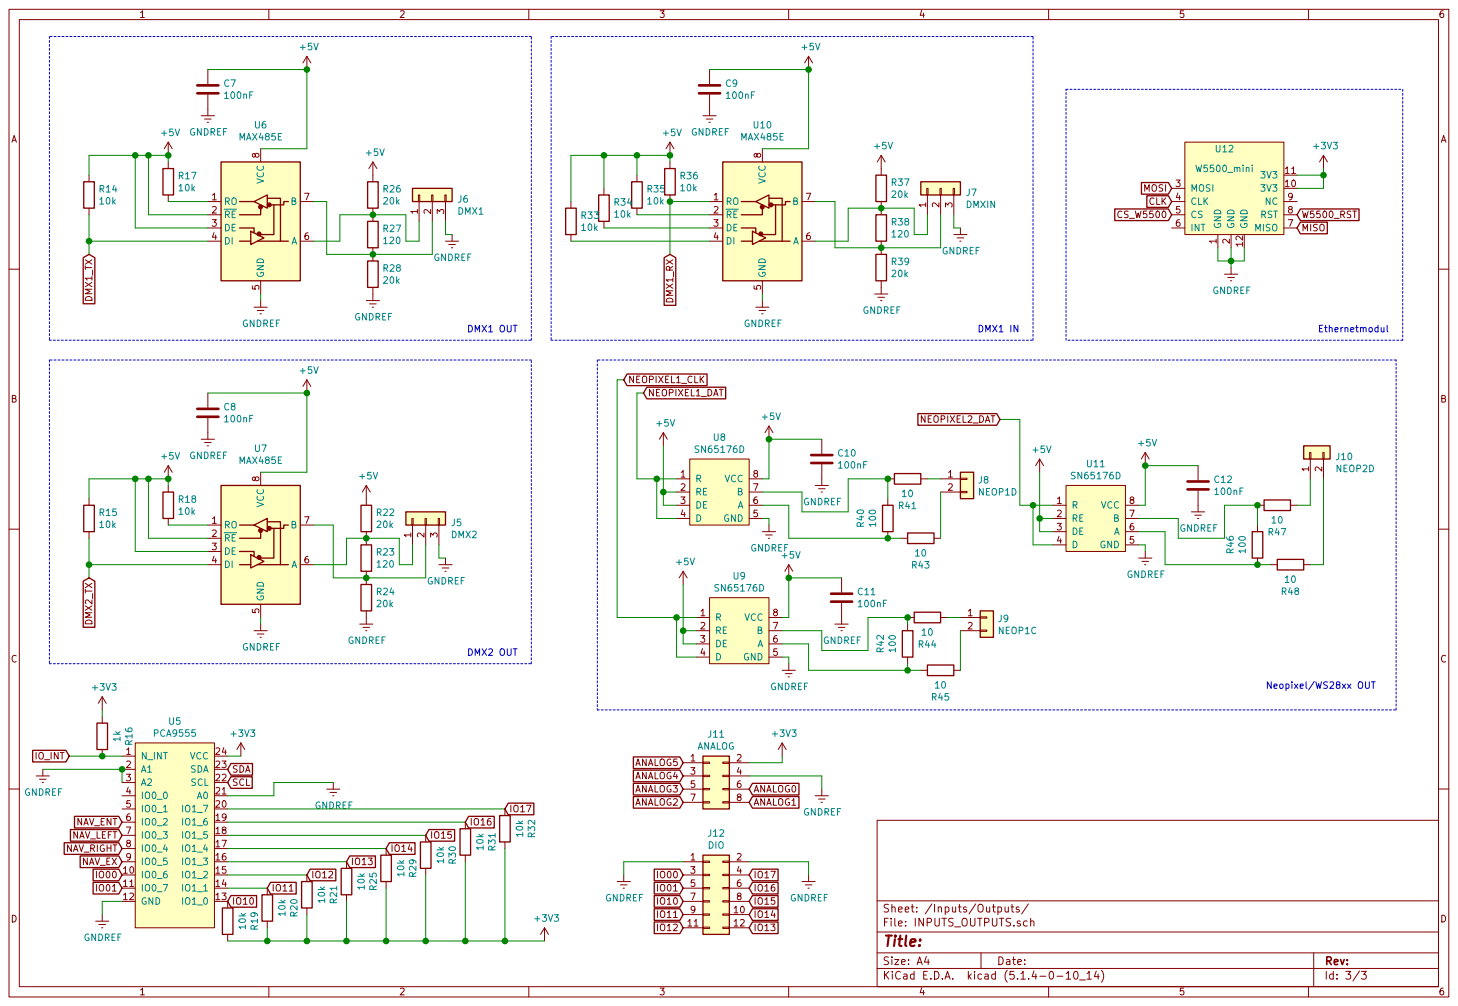
[picture p37: page 3]

8 U10 MAX485E RO 1 RE 2 DE 3 DI 4 GND
