kokospalme/HW_LipoMeter5S/Firepot/Docs/Firepot.pdf

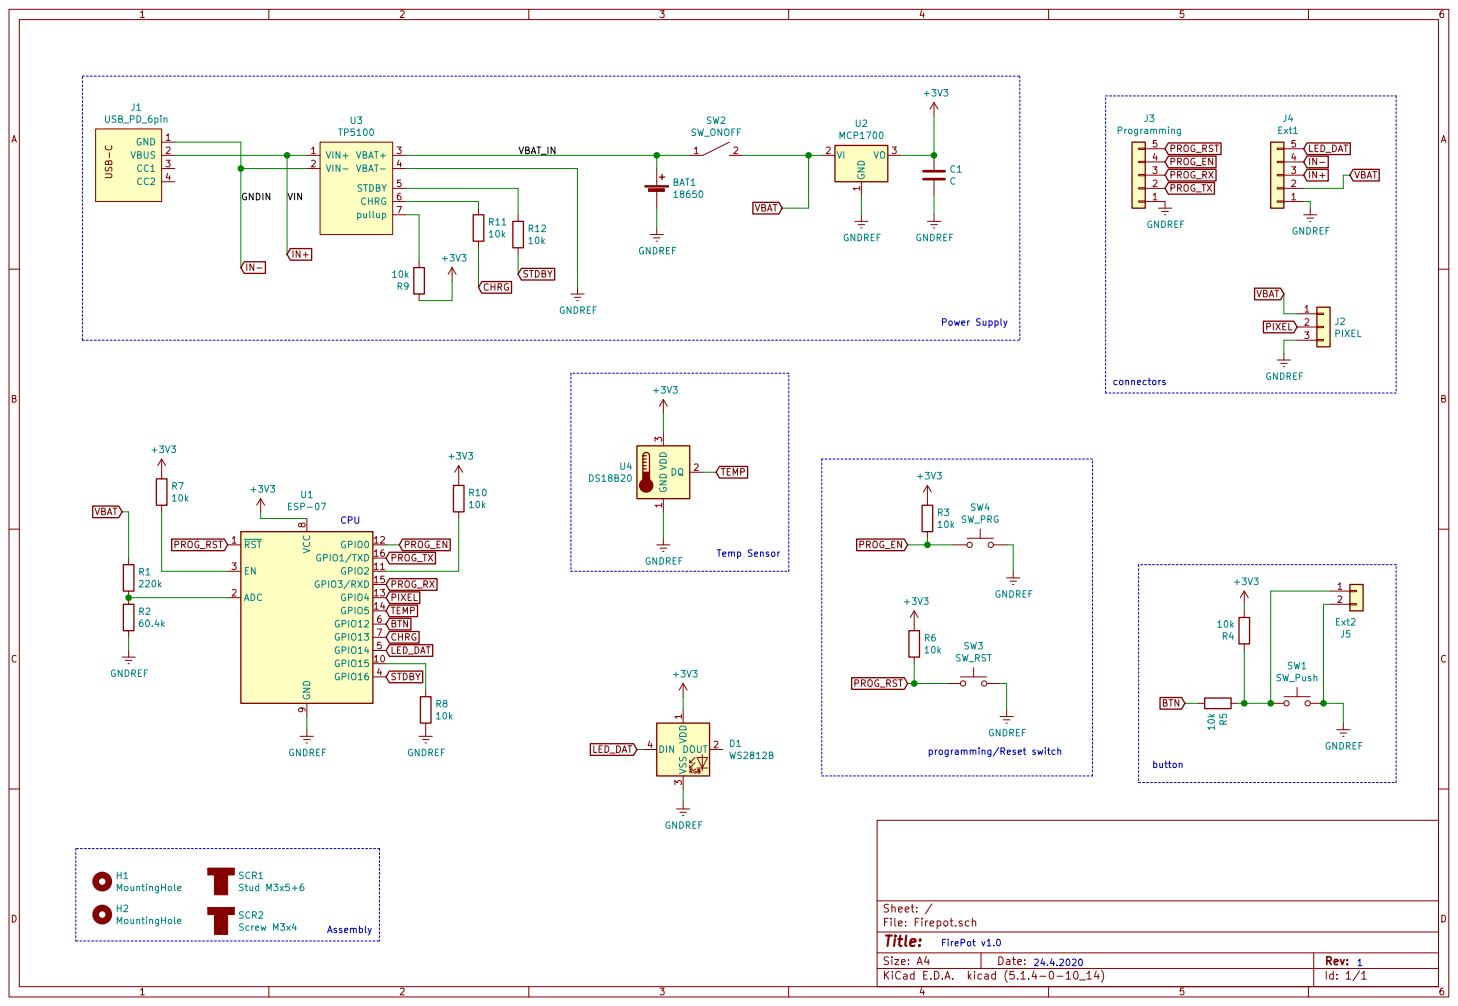
[picture p38: page 1]

1 VI 2 VO 3 U2 MCP1700 GNDREF GNDREF

1 DOUT 2 VSS
File: Firepot.sch Sheet: / RGB VDD
