kokospalme/HW_LipoMeter5S/ProgrammerController/test1.PDF

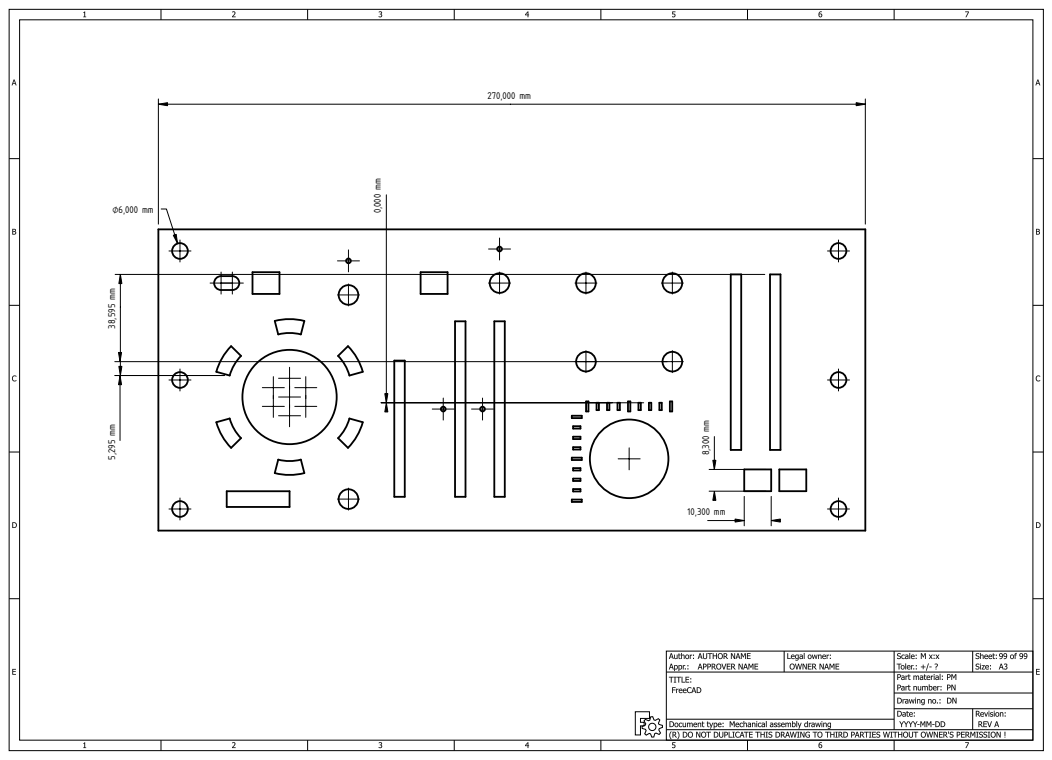
[picture p39: page 1]
