kokospalme/HW_LipoMeter5S/Docs/Alice' Hase2.pdf

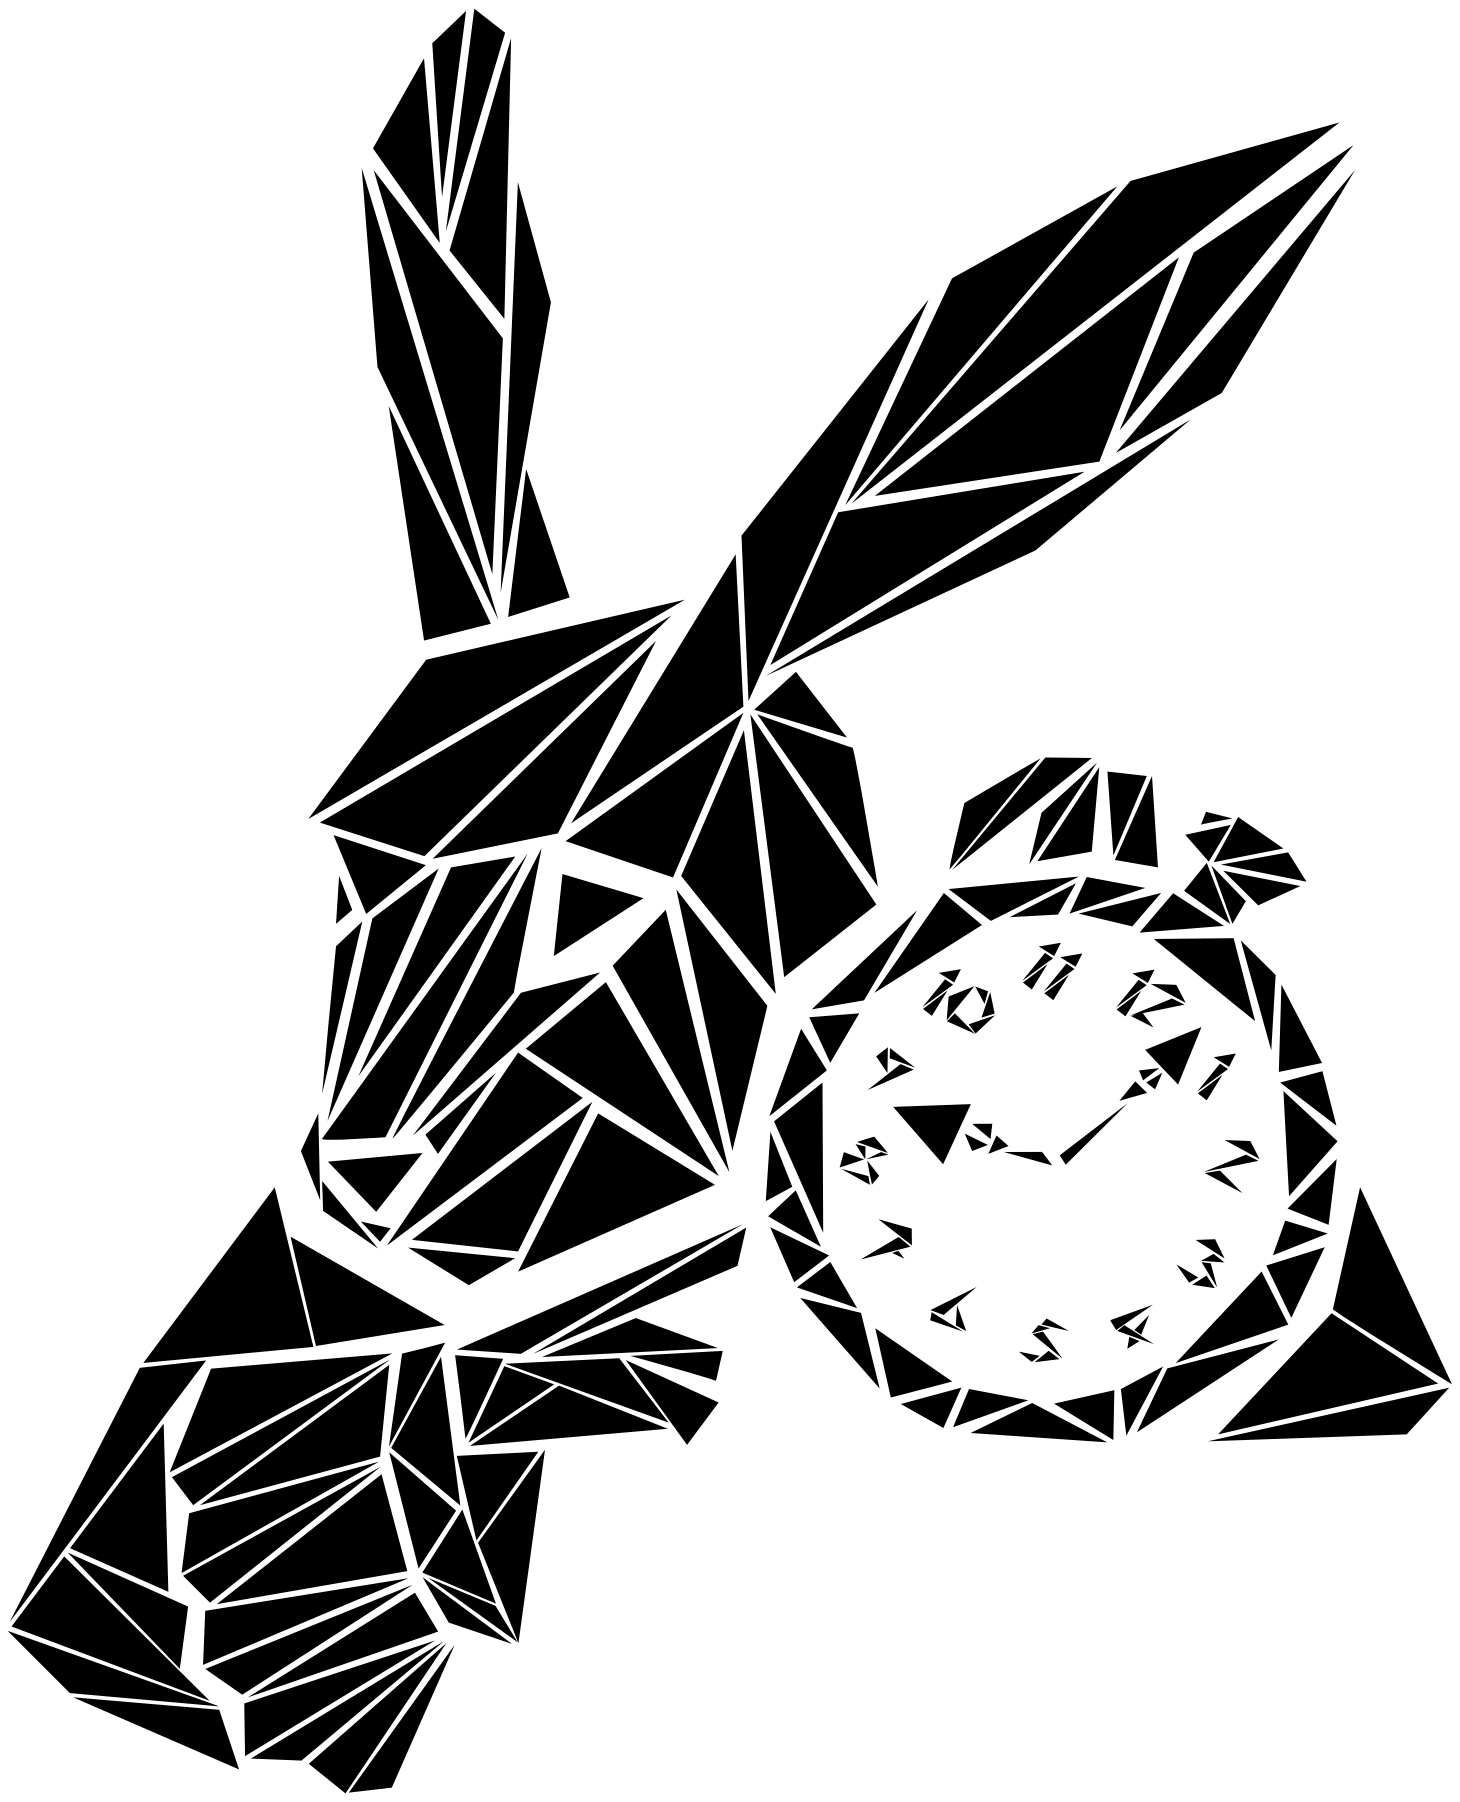
[picture p40: page 1]
