kokospalme/HW_LipoMeter5S/PicoPar6/CAD/Leuchtmittelblech Zeichnung v1.pdf

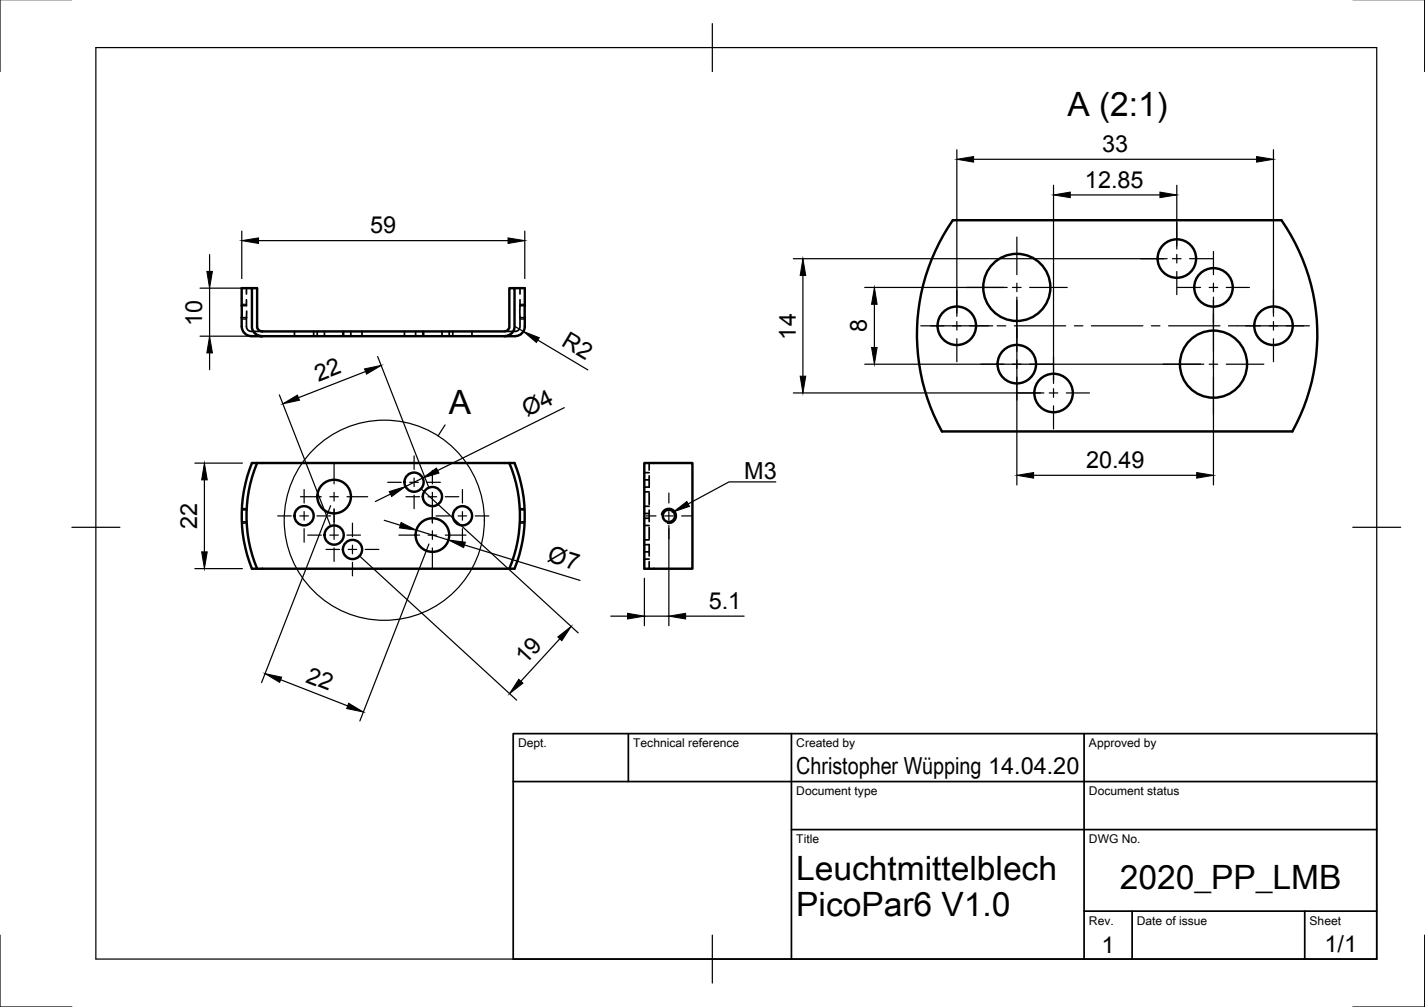
[picture p41: page 1]

Dept. | Technical reference | Created by Christopher Wüpping 14.04.20 | Approved by

Document type | Document status

Title Leuchtmittelblech PicoPar6 V1.0 | DWG No. 2020_PP_LMB

Rev. 1 | Date of issue | Sheet 1/1
