kokospalme/HW_LipoMeter5S/PicoPar6/CAD/Mainboard_Zeichnung_V0.5_Skizze.pdf

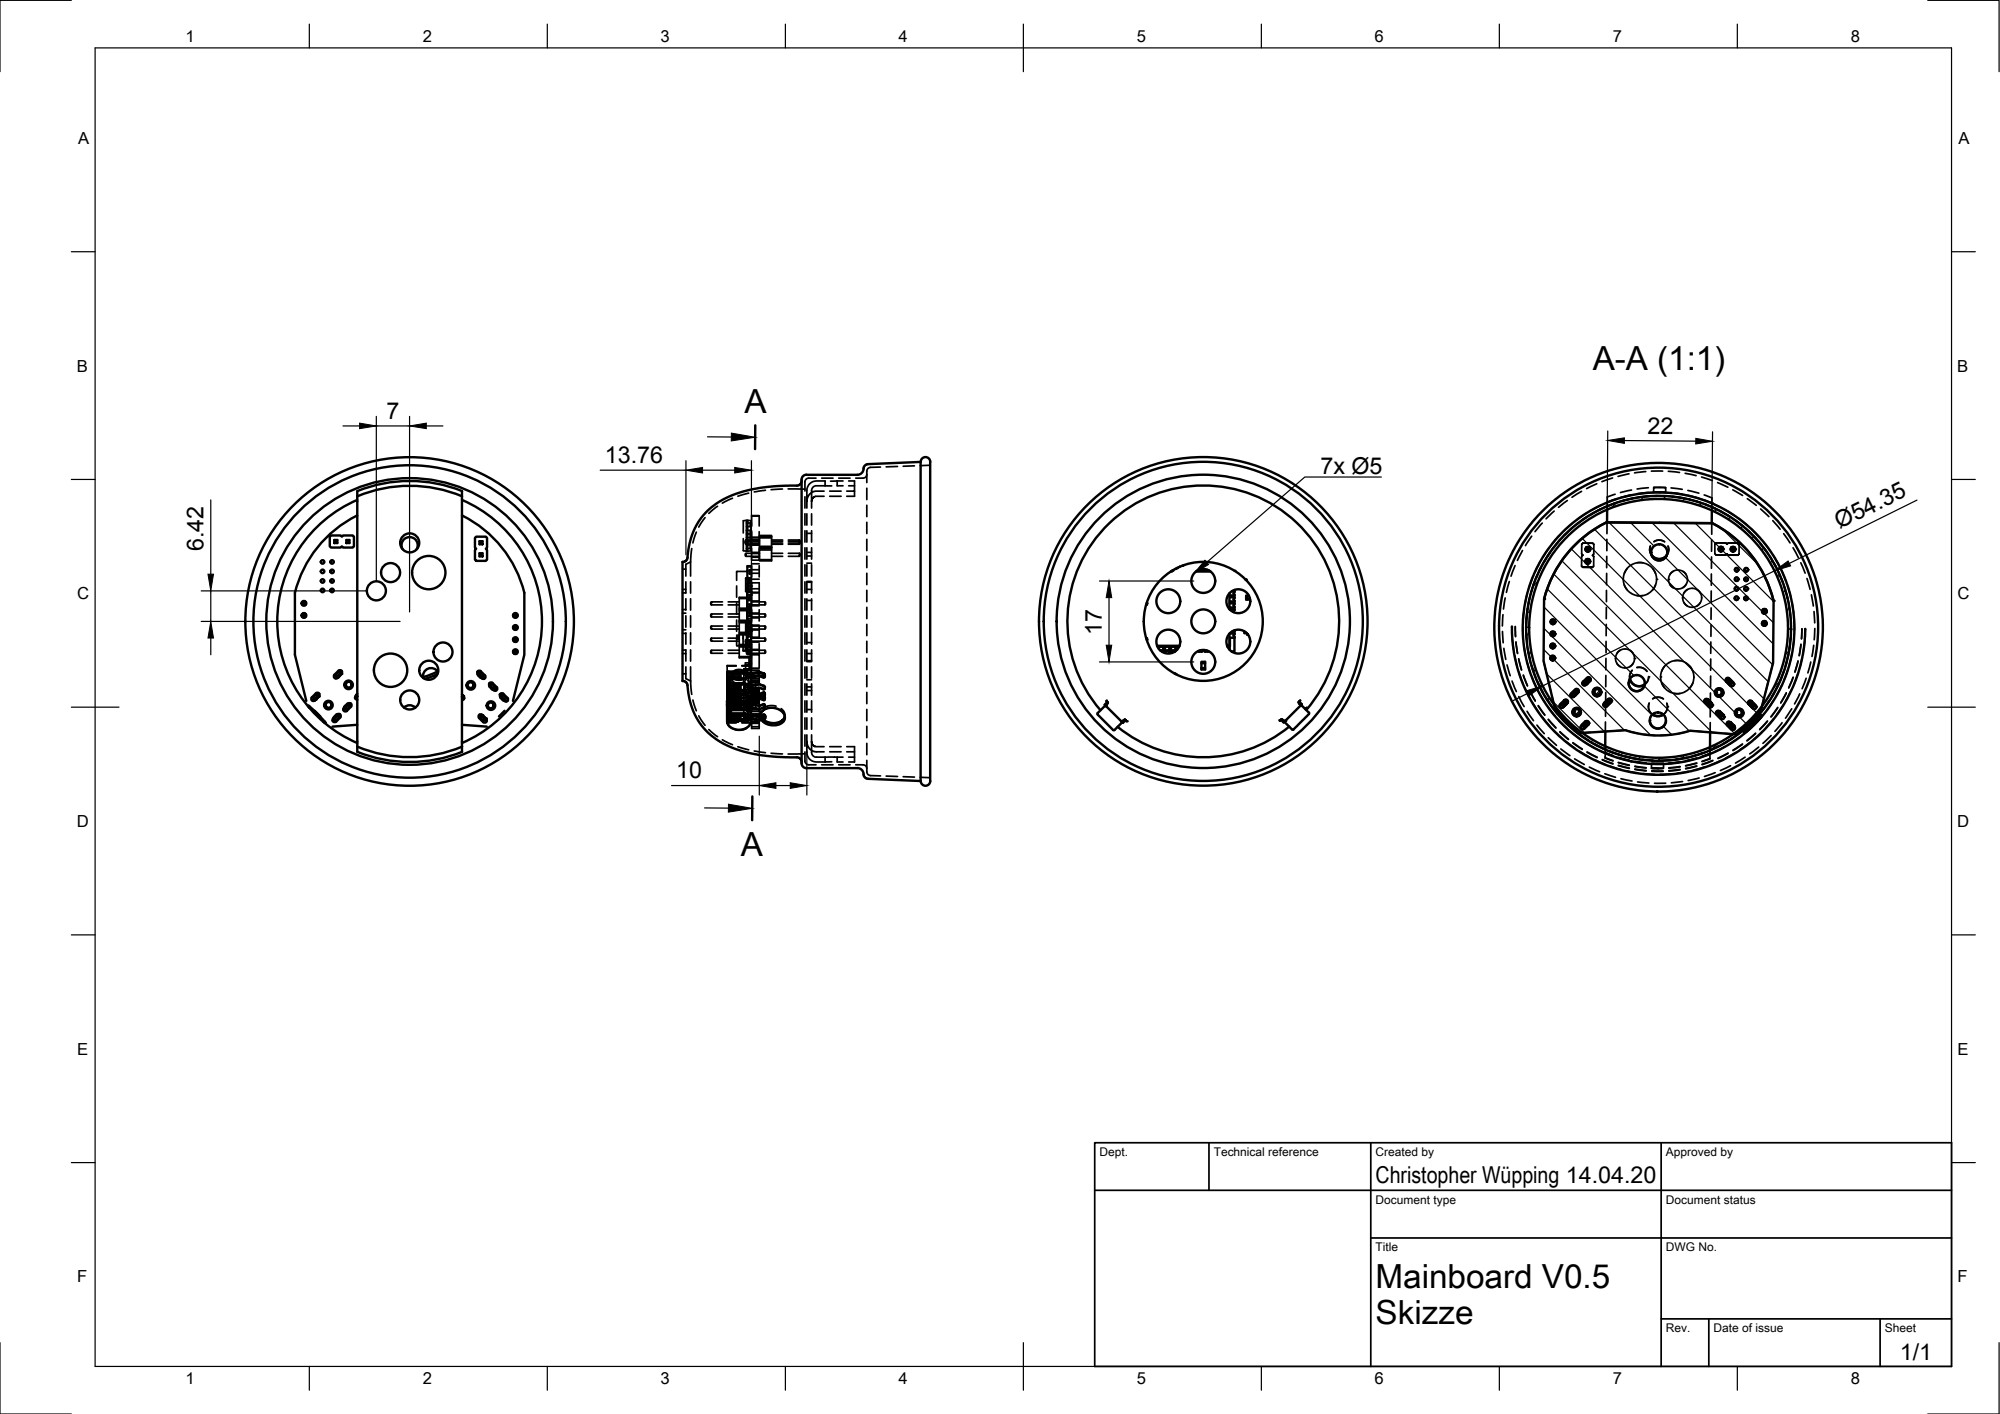
[picture p42: page 1]

Dept. | Technical reference | Created by Christopher Wüpping 14.04.20 | Approved by

Document type | Document status

Title Mainboard V0.5 Skizze | DWG No.

Rev. | Date of issue | Sheet 1/1
