kokospalme/HW_LipoMeter5S/ProgrammerController/Models/Faceplate/2020LUM1PROGFACEV1_0.pdf

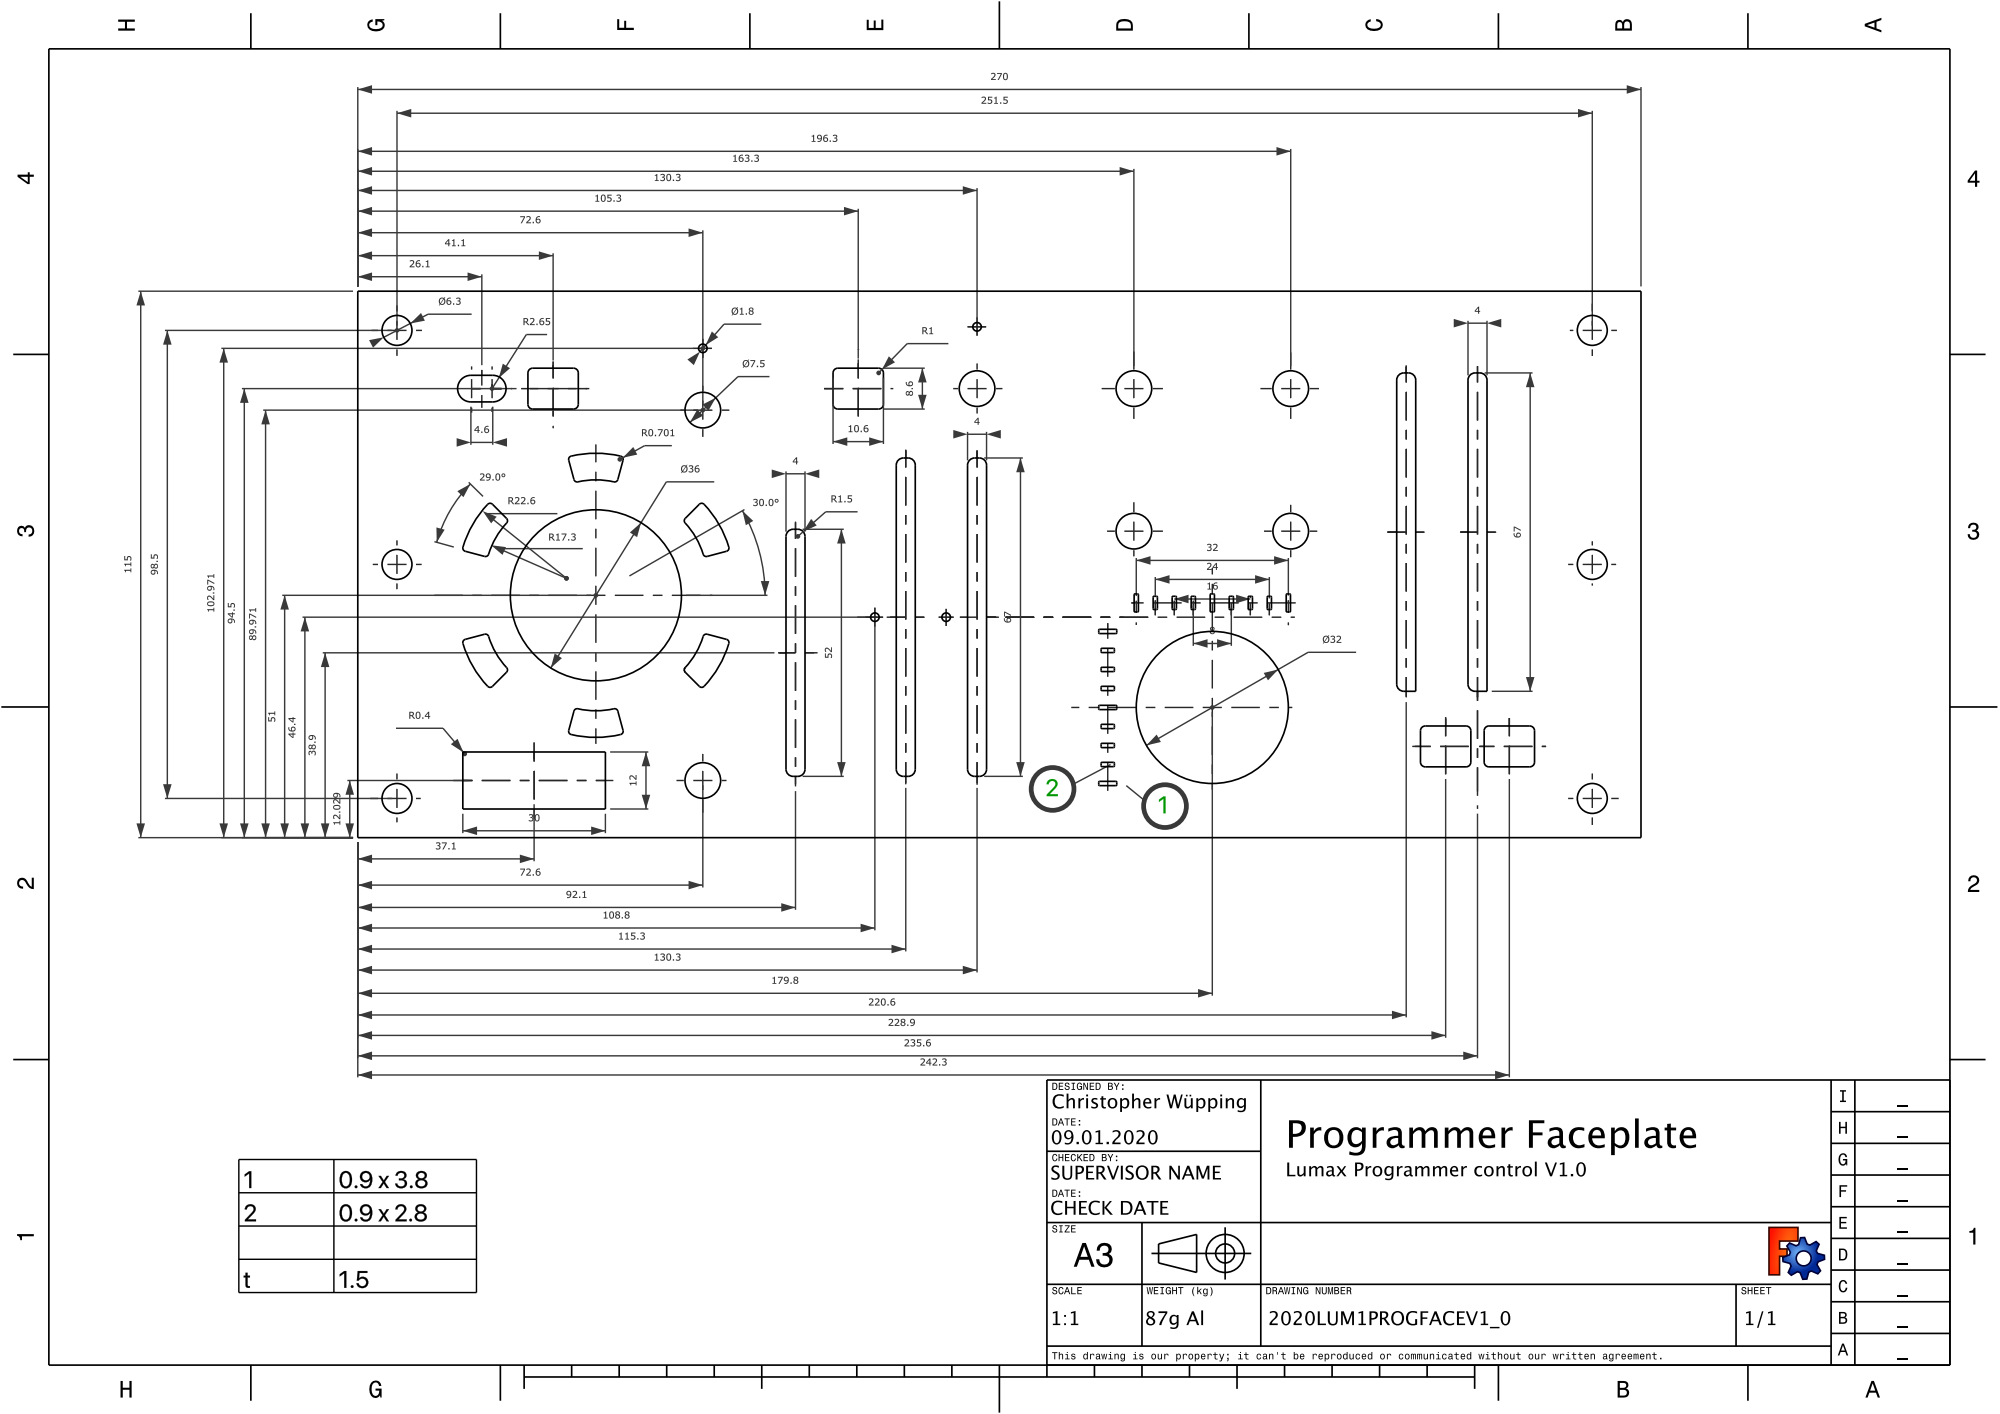
[picture p43: page 1]
