kokospalme/HW_LipoMeter5S/PicoPar6/PicoPar6_Mainboard/V2/PDF/PCB_V2_0/PicoPar6_Mainboard-B_Mask.pdf

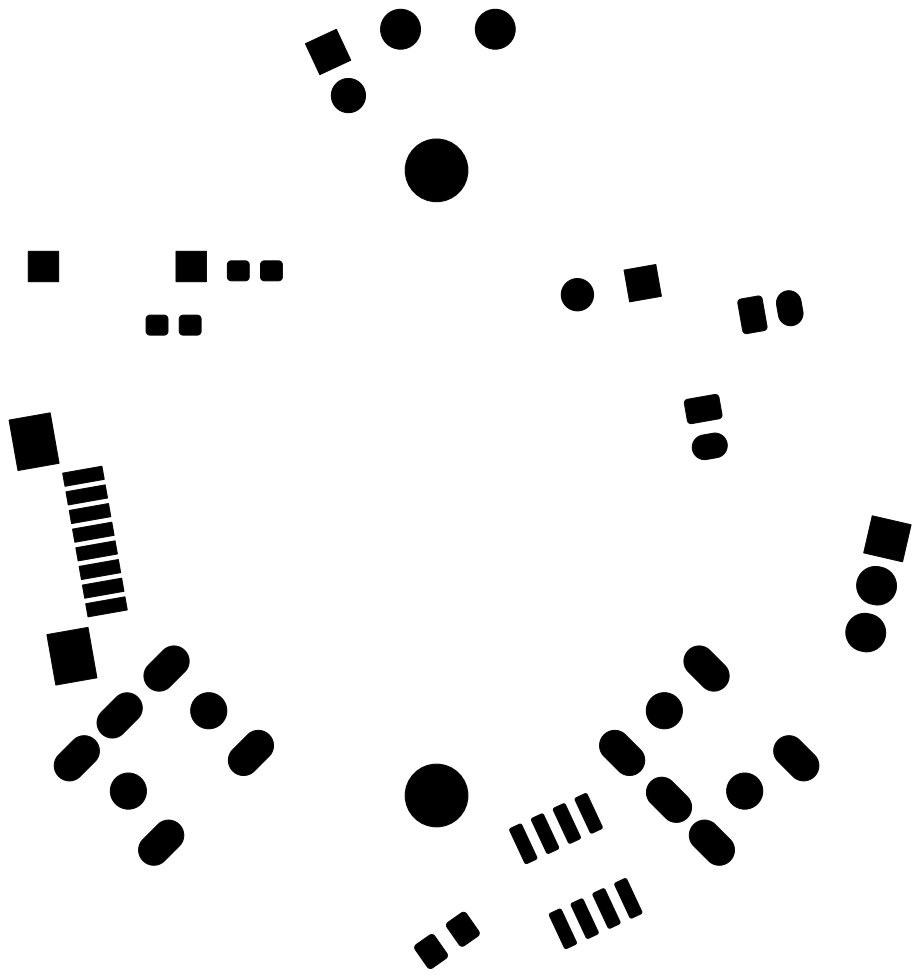
[picture p45: page 1]
