kokospalme/HW_LipoMeter5S/PicoPar6/PicoPar6_Mainboard/V2/PDF/SCH_V2_0/PicoPar6_Mainboard_V2.pdf

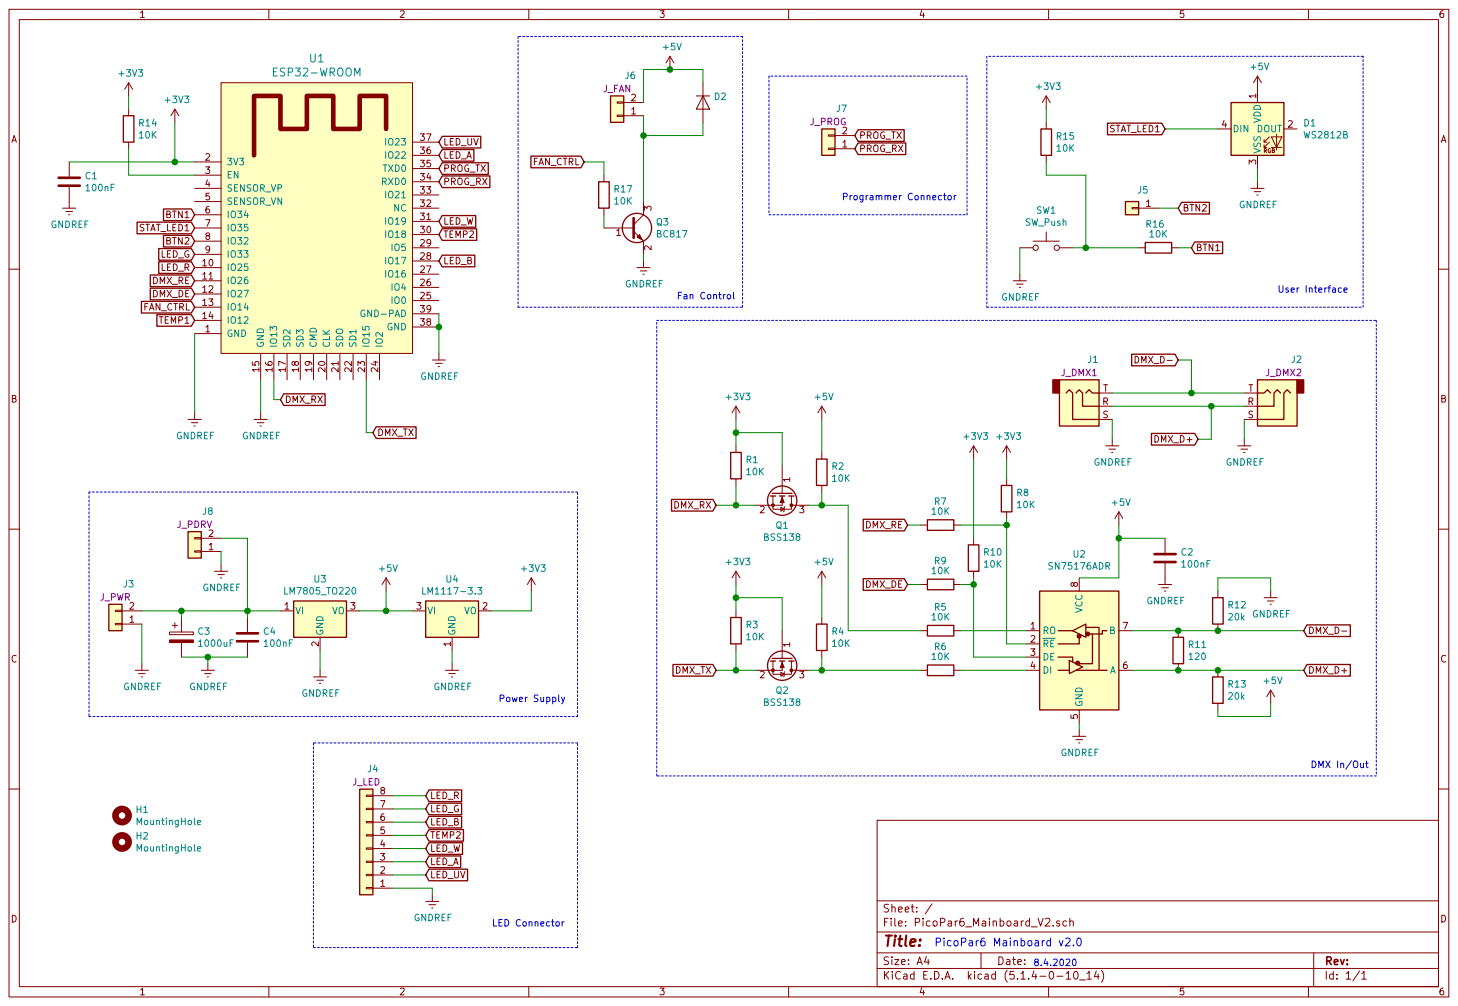
[picture p52: page 1]
