kokospalme/HW_LipoMeter5S/PicoPar6/PicoPar6_Mainboard/V1/PDF/V1.1/PicoPar6_SCH_Mainboard.pdf

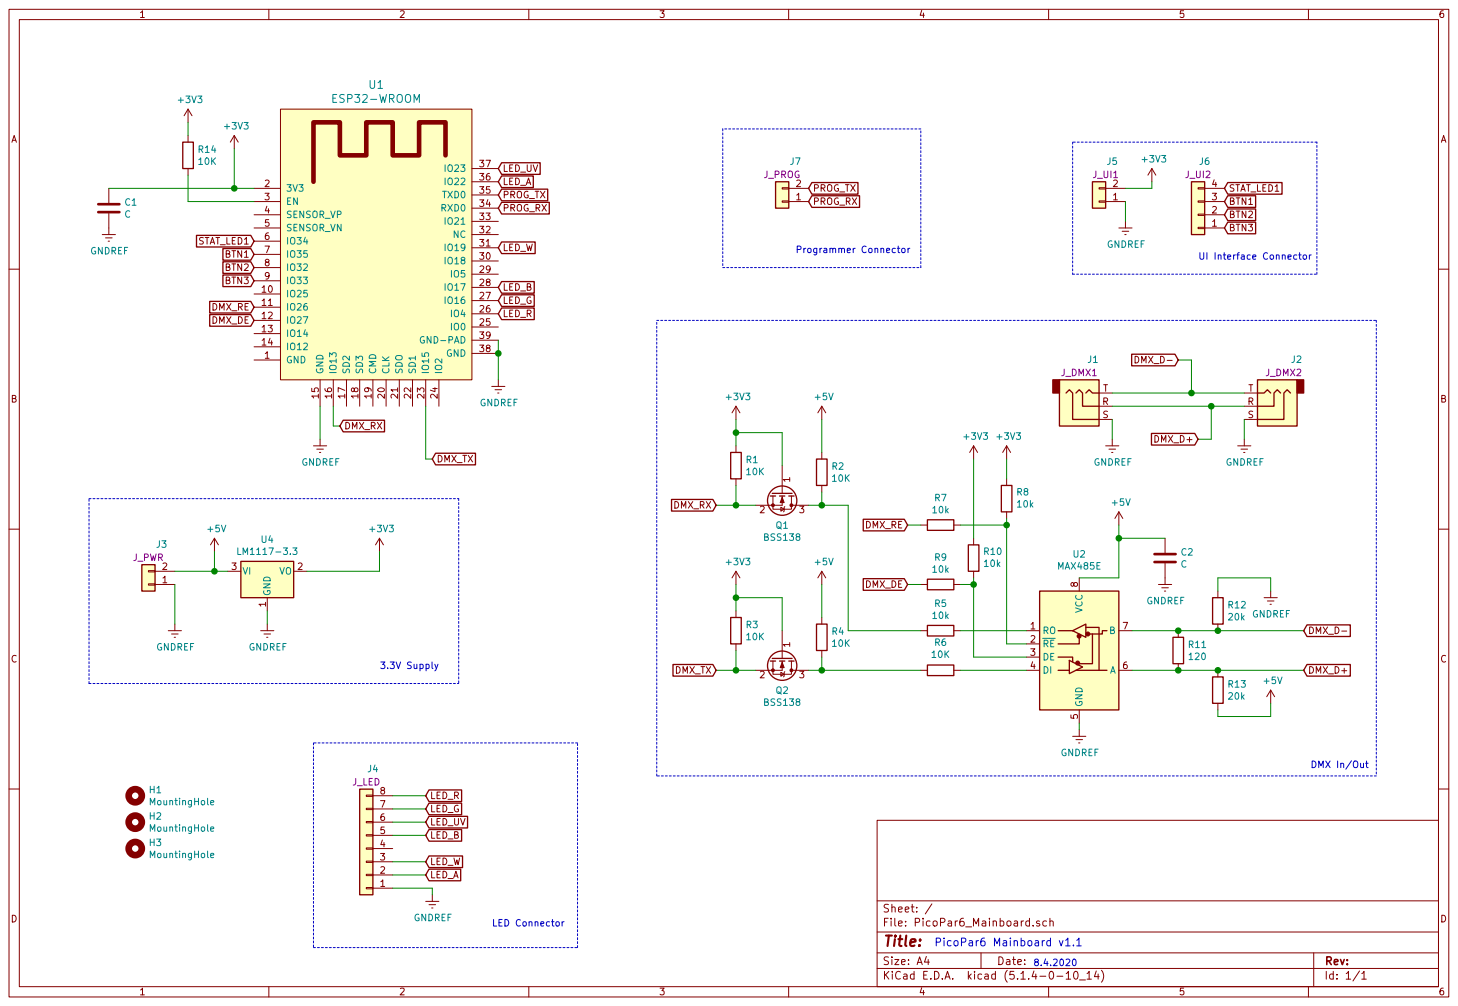
[picture p53: page 1]

UI Interface Connector Programmer Connector

File: PicoPar6_Mainboard.sch Sheet: / GNDREF H3MountingHole
