kokospalme/HW_LipoMeter5S/PicoPar6/PicoPar6_Mainboard/V1/PDF/V1.1/PicoPar6_Mainboard-B_Cu.pdf

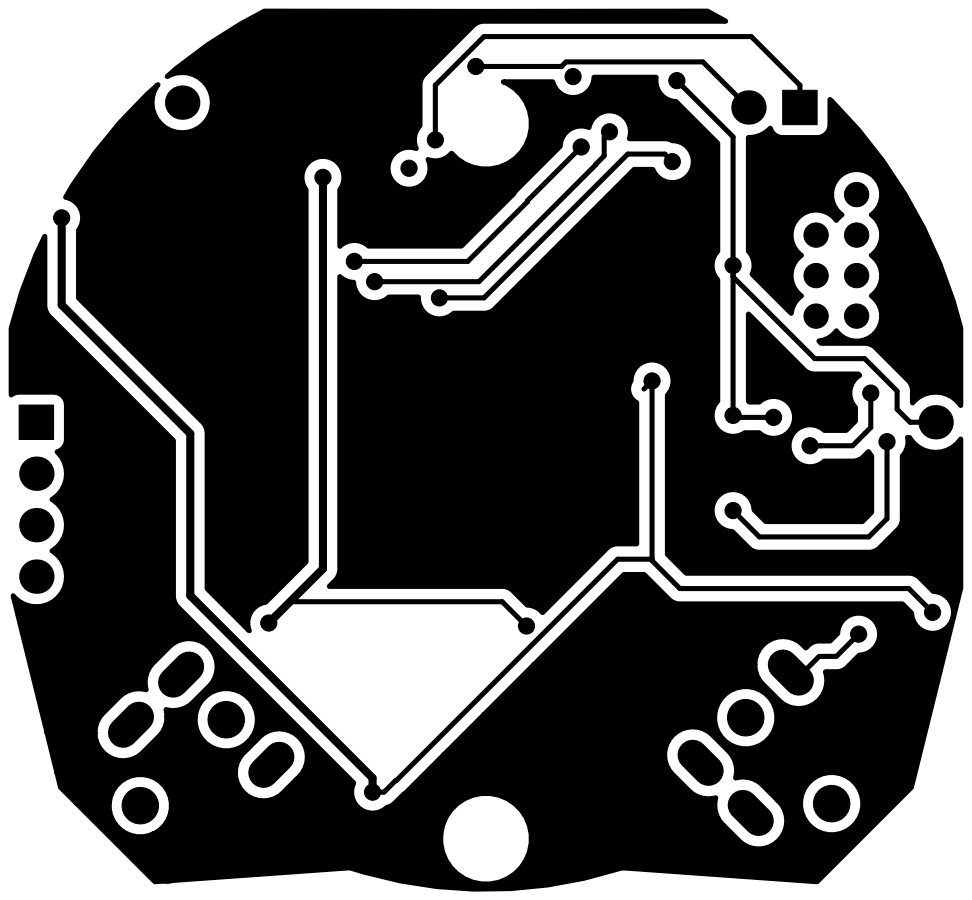
[picture p54: page 1]
