kokospalme/HW_LipoMeter5S/PicoPar6/PicoPar6_Mainboard/V1/PDF/V1.1/PicoPar6_Mainboard-B_Mask.pdf

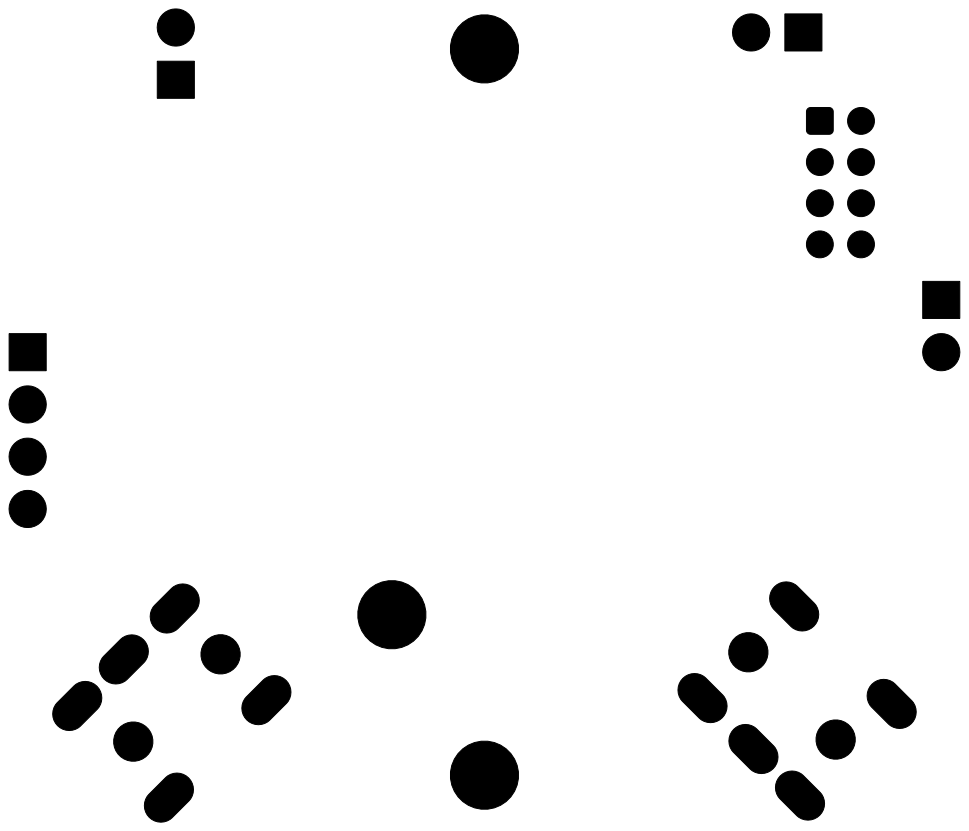
[picture p55: page 1]
