kokospalme/HW_LipoMeter5S/PicoPar6/PicoPar6_Mainboard/V1/PDF/V1.1/PicoPar6_Mainboard-Edge_Cuts.pdf

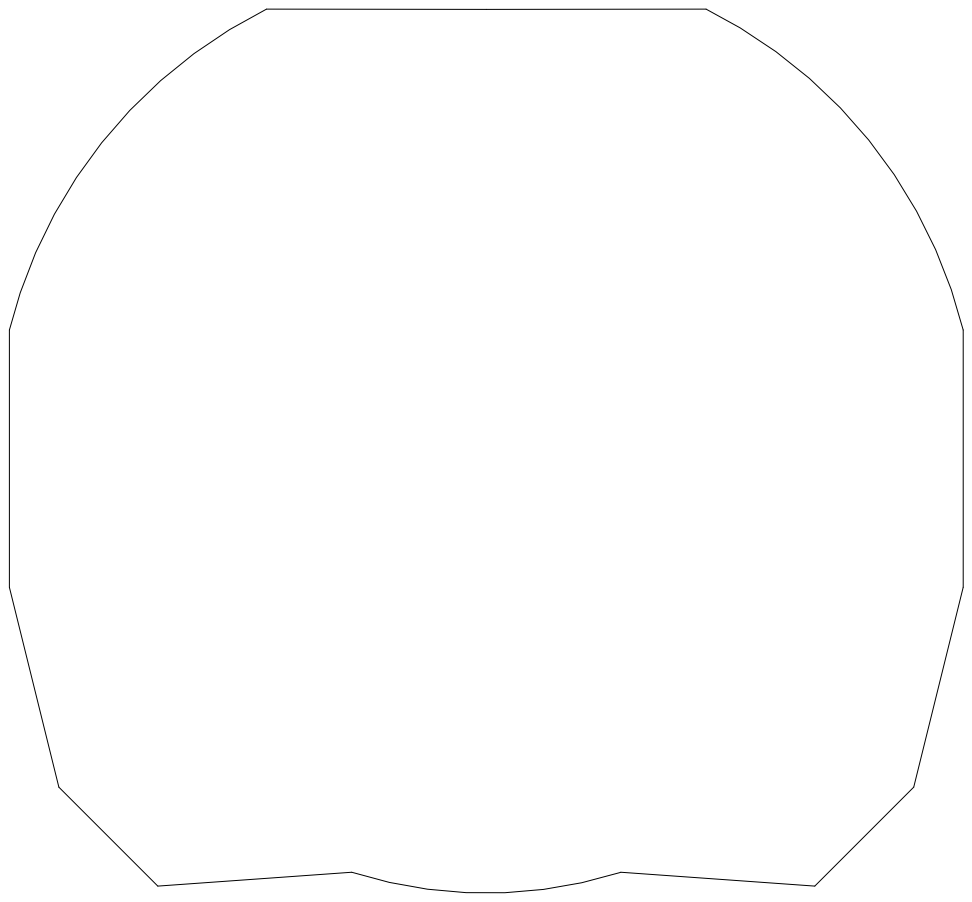
[picture p57: page 1]
