kokospalme/HW_LipoMeter5S/PicoPar6/PicoPar6_Mainboard/V1/PDF/V1.1/PicoPar6_Mainboard-F_Cu.pdf

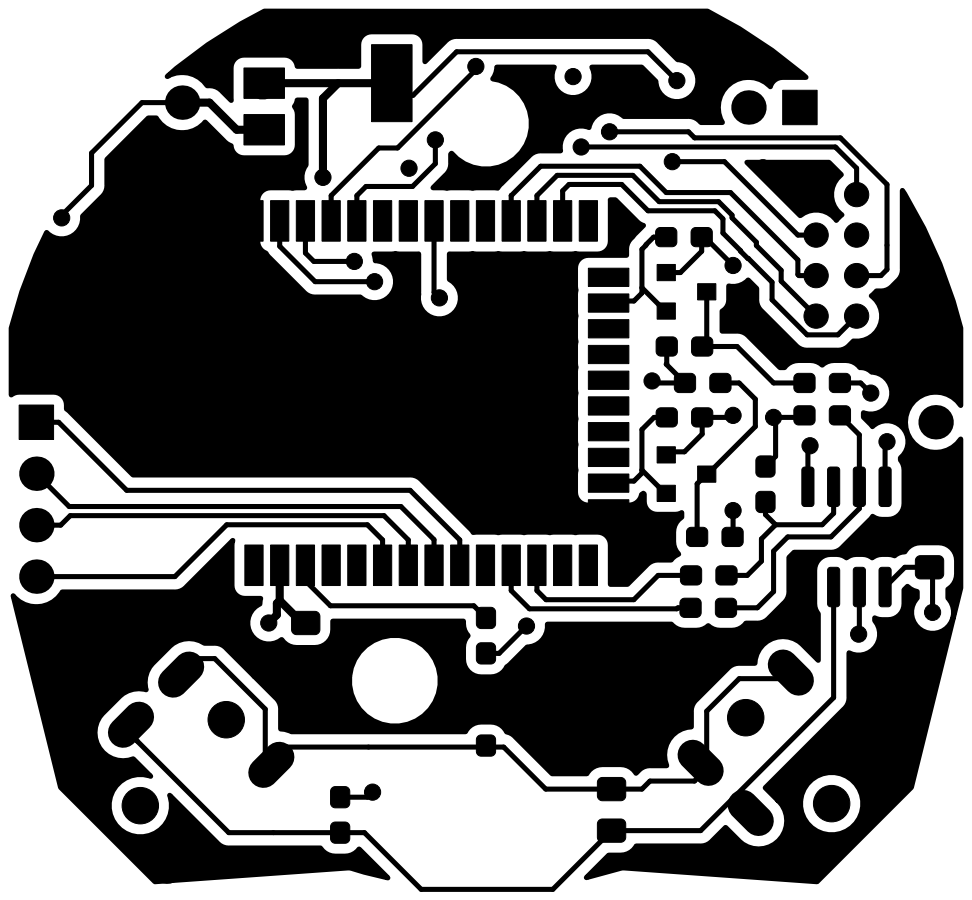
[picture p58: page 1]
