kokospalme/HW_LipoMeter5S/(list of files, drawings)

Other design files:
PicoPar6/PicoPar6_Driver/EasyEDA_PicoPar6_DriverPCB_V1_0/Pico6 Par_Driver PCB_V1_0.json
